wmarchewka/class_4_test/docs/portable_pinouts.xlsx

Sheet: rpi_pinouts
Header Pin Number | BCM Pin/Number | Portable Tester Usage |  |  | Header Pin Number | BCM Pin/Number | Portable Tester Usage | LCD
1 | 3V3 Power |  |  | SPI | 1 | 3V3 Power |  |  | SPI
2 | 5V Power |  |  | Ground | 17 | 3V3 Power |  |  | Ground
3 | BCM 2 (SDA) |  |  | Power | 2 | 5V Power |  |  | Power
4 | 5V Power |  |  | Rotary Encoder | 4 | 5V Power |  |  | Rotary Encoder
5 | BCM 3 (SCL) | Rotary Encoder 1 Pin B |  | Decoder | 27 | BCM 0 | I2C_SD EEPEOM | SHARED | Decoder
6 | Ground |  |  | LCD | 28 | BCM 1 | I2X_SC EEPROM | SHARED | LCD
7 | BCM 4 (GPCLK0) | Rotary Encoder 1 Pin A |  | I2C | 3 | BCM 2 (SDA) | LCD I2C SDA TOUCH |  | I2C
8 | BCM 14 (TXD) | Rotary Encoder 1 Pin B |  |  | 5 | BCM 3 (SCL) | LCD I2C SCL TOUCH
9 | Ground |  |  |  | 7 | BCM 4 (GPCLK0) | Rotary Encoder 1 Pin A
10 | BCM 15 (RXD) | Rotary Encoder 2 Pin A |  |  | 29 | BCM 5 | Decoder_0 PIN A
11 | BCM 17 | SPI1 CS1 | INT TS |  | 31 | BCM 6 | Decoder_0 PIN B
12 | BCM 18 (PWM0) | SPI1 CS0 |  |  | 26 | BCM 7 (CE1) | SPI_0 CS1
13 | BCM 27 | DISPLAY KEYIRQ |  |  | 24 | BCM 8 (CE0) | SPI_0 CS0
14 | Ground |  |  |  | 21 | BCM 9 (MISO) | MISO SPI_0
15 | BCM 22 | Rotary Encoder 2 Pin B |  |  | 19 | BCM 10 (MOSI) | MOSI SPI_0
16 | BCM 23 | Rotary Encoder 3 Pin A |  |  | 23 | BCM 11 (SCLK) | SCLK SPI_0
17 | 3V3 Power |  |  |  | 32 | BCM 12 (PWM0) | Rotary Encoder 4 Pin B
18 | BCM 24 | Rotary Encoder 3 Pin B |  |  | 33 | BCM13 (PWM 1) | Decoder_0 PIN C
19 | BCM 10 (MOSI) | MOSI SPI_0 |  |  | 8 | BCM 14 (TXD) | Rotary Encoder 1 Pin B
20 | Ground |  |  |  | 10 | BCM 15 (RXD) | Rotary Encoder 2 Pin A
21 | BCM 9 (MISO) | MISO SPI_0 |  |  | 36 | BCM 16 | SPI1 CS2
22 | BCM 25 | Rotary Encoder 4 Pin A |  |  | 11 | BCM 17 | SPI1 CS1
23 | BCM 11 (SCLK) | SCLK SPI_0 |  |  | 12 | BCM 18 (PWM0) | SPI1 CS0
24 | BCM 8 (CE0) | SPI0 CS0 |  |  | 35 | BCM 19 (MISO) | MISO SPI_1
25 | Ground |  |  |  | 38 | BCM 20 (MOSI) | MOSI SPI_1
26 | BCM 7 (CE1) | SPI0 CS1 |  |  | 40 | BCM 21 (SCLK) | SCLK SPI_1
27 | BCM 0 | I2C_SD EEPROM |  |  | 15 | BCM 22 | Rotary Encoder 2 Pin B
28 | BCM 1 | I2C_SC EEPROM |  |  | 16 | BCM 23 | Rotary Encoder 3 Pin A
29 | BCM 5 | Decoder_0 |  |  | 18 | BCM 24 | Rotary Encoder 3 Pin B
30 | Ground |  |  |  | 22 | BCM 25 | Rotary Encoder 4 Pin A
31 | BCM 6 | Decoder_0 |  |  | 37 | BCM 26 | FREE PIN
32 | BCM 12 (PWM0) | Rotary Encoder 4 Pin B |  |  | 13 | BCM 27 | DISPLAY KEYIRQ |  | NOT NEEDED
33 | BCM13 (PWM 1) | Decoder_0 |  |  | 6 | Ground
34 | Ground |  |  |  | 9 | Ground
35 | BCM 19 (MISO) | MISO SPI_1 |  |  | 14 | Ground
36 | BCM 16 | SPI1 CS2 |  |  | 20 | Ground
37 | BCM 26 | FREE PIN |  |  | 25 | Ground
38 | BCM 20 (MOSI) | MOSI SPI_1 |  |  | 30 | Ground
39 | Ground |  |  |  | 34 | Ground
40 | BCM 21 (SCLK) | SCLK SPI_1 |  |  | 39 | Ground

Sheet: IC PINOUTS
MAIN FUNCTION | IC | IC NAME | FUNCTION | PIN | IC FUNCTION | NET | FROM | TO | DESCRIPTION
TRACK RCV CODE RATE GEN | U1 | AD9833WBRMZ | SIGNAL GENERATOR PRIMARY | 6 | SDATA | BCM20_MOSI1 | PCBA |  | SPI1 DATA
TRACK RCV CODE RATE GEN | U1 | AD9833WBRMZ | SIGNAL GENERATOR PRIMARY | 7 | SCLK | BCM21_SCK1 | PCBA |  | SPI1 CLOCK
TRACK RCV CODE RATE GEN | U1 | AD9833WBRMZ | SIGNAL GENERATOR PRIMARY | 5 | MCLK | CLK1 | U11 |  | CLOCK SIGNAL
TRACK RCV CODE RATE GEN | U1 | AD9833WBRMZ | SIGNAL GENERATOR PRIMARY | 8 | FSYNC | CS0 | U21.15 |  | CHIP SELECT
TRACK RCV CODE RATE GEN | U1 | AD9833WBRMZ | SIGNAL GENERATOR PRIMARY | 10 | VOUT | PRIMARY CHANNEL | U1.10 |  | PRIMARY CHANNEL OUTPUT
TRACK RCV CODE RATE GEN | U10 | OPA552UA | SIGNAL AMPLIFIER | 2 | INPUT POS
TRACK RCV CODE RATE GEN | U10 | OPA552UA | SIGNAL AMPLIFIER | 3 | INPUT NEG |  | U9.8
TRACK RCV CODE RATE GEN | U10 | OPA552UA | SIGNAL AMPLIFIER | 6 | OUTPUT |  |  | TPA2
TRACK RCV CODE RATE GEN | U11 | 551MILF | CLOCK BUFFER | 2 | Q1 | CLK1 |  | U1.5 | CLOCK USED FOR SIGNAL GENERATOR
TRACK RCV CODE RATE GEN | U11 | 551MILF | CLOCK BUFFER | 3 | Q2 | CLK2 |  | U5.5 | CLOCK USED FOR SIGNAL GENERATOR
TRACK RCV CODE RATE GEN | U11 | 551MILF | CLOCK BUFFER | 1 | ICLK |  | Y1.3
SPEED SIMULATION TACH 1 | U12 | ADUM3154ARSZ | SPI ISOLATOR | 4 | MO | BCM20_MOSI1 | PCBA.20
SPEED SIMULATION TACH 1 | U12 | ADUM3154ARSZ | SPI ISOLATOR | 3 | MCLK | BCM21_SCK1 | PCBA.21
SPEED SIMULATION TACH 1 | U12 | ADUM3154ARSZ | SPI ISOLATOR | 18 | SCLK | CS_TACH1 |  | U14.8
SPEED SIMULATION TACH 1 | U12 | ADUM3154ARSZ | SPI ISOLATOR | 6 | MSS | CS6 | U21.9
SPEED SIMULATION TACH 1 | U12 | ADUM3154ARSZ | SPI ISOLATOR | 17 | SI | MOSI2_TACH1 |  | U14.6
SPEED SIMULATION TACH 1 | U12 | ADUM3154ARSZ | SPI ISOLATOR | 15 | SS0 | SCK2_TACH1 |  | U14.7
SPEED SIMULATION TACH 2 | U13 | ADUM3154ARSZ | SPI ISOLATOR | 4 | MO | BCM20_MOSI1 | PCBA.20
SPEED SIMULATION TACH 2 | U13 | ADUM3154ARSZ | SPI ISOLATOR | 3 | MCLK | BCM21_SCK1 | PCBA.21
SPEED SIMULATION TACH 2 | U13 | ADUM3154ARSZ | SPI ISOLATOR | 18 | SCLK | CS_TACH2 |  | U17.8
SPEED SIMULATION TACH 2 | U13 | ADUM3154ARSZ | SPI ISOLATOR | 6 | MSS | CS7 | U21.7
SPEED SIMULATION TACH 2 | U13 | ADUM3154ARSZ | SPI ISOLATOR | 17 | SI | MOSI2_TACH2 |  | U17.6
SPEED SIMULATION TACH 2 | U13 | ADUM3154ARSZ | SPI ISOLATOR | 15 | SS0 | SCK2_TACH2 |  | U17.7
SPEED SIMULATION TACH 1 | U14 | AD9833WBRMZ | SIGNAL GENERATOR PRIMARY | 5 | MCLK | CLK_TACH1 | Y2.3 | U15.2
SPEED SIMULATION TACH 1 | U14 | AD9833WBRMZ | SIGNAL GENERATOR PRIMARY | 6 | SDATA | MOSI2_TACH1 | U12.17
SPEED SIMULATION TACH 1 | U14 | AD9833WBRMZ | SIGNAL GENERATOR PRIMARY | 7 | SCLK | SCK2_TACH1 | U12.18
SPEED SIMULATION TACH 1 | U14 | AD9833WBRMZ | SIGNAL GENERATOR PRIMARY | 8 | FSYNC | CS_TACH1 | U12.15
SPEED SIMULATION TACH 1 | U14 | AD9833WBRMZ | SIGNAL GENERATOR PRIMARY | 10 | VOUT |  |  | TP16,U15.2
SPEED SIMULATION TACH 1 | U15 | MC33071ADR2G | GAIN CONTROL PRIMARY | 2 | INPUT NEG |  | U14.10
SPEED SIMULATION TACH 1 | U15 | MC33071ADR2G | GAIN CONTROL PRIMARY | 3 | INPUT POS
SPEED SIMULATION TACH 1 | U15 | MC33071ADR2G | GAIN CONTROL PRIMARY | 6 | OUTPUT |  |  | U16.2
SPEED SIMULATION TACH 1 | U16 | MC33071ADR2G | GAIN CONTROL PRIMARY | 2 | INPUT NEG |  | U15.6
SPEED SIMULATION TACH 1 | U16 | MC33071ADR2G | GAIN CONTROL PRIMARY | 3 | INPUT POS
SPEED SIMULATION TACH 1 | U16 | MC33071ADR2G | GAIN CONTROL PRIMARY | 6 | OUTPUT |  |  | TP20
SPEED SIMULATION TACH 2 | U17 | AD9833WBRMZ | SIGNAL GENERATOR PRIMARY | 5 | MCLK | CLK_TACH2 | Y3.3
SPEED SIMULATION TACH 2 | U17 | AD9833WBRMZ | SIGNAL GENERATOR PRIMARY | 6 | SDATA | MOSI2_TACH2 | U13.17
SPEED SIMULATION TACH 2 | U17 | AD9833WBRMZ | SIGNAL GENERATOR PRIMARY | 7 | SCLK | SCK2_TACH2 | U13.18
SPEED SIMULATION TACH 2 | U17 | AD9833WBRMZ | SIGNAL GENERATOR PRIMARY | 8 | FSYNC | CS_TACH2 | U13.15
SPEED SIMULATION TACH 2 | U17 | AD9833WBRMZ | SIGNAL GENERATOR PRIMARY | 10 | VOUT |  |  | TP18,U18.2
SPEED SIMULATION TACH 2 | U18 | MC33071ADR2G | GAIN CONTROL PRIMARY | 2 | INPUT NEG |  | U17.10
SPEED SIMULATION TACH 2 | U18 | MC33071ADR2G | GAIN CONTROL PRIMARY | 3 | INPUT POS
SPEED SIMULATION TACH 2 | U18 | MC33071ADR2G | GAIN CONTROL PRIMARY | 6 | OUTPUT |  |  | U19.2
SPEED SIMULATION TACH 2 | U19 | MC33071ADR2G | GAIN CONTROL PRIMARY | 2 | INPUT NEG |  | U18.6
SPEED SIMULATION TACH 2 | U19 | MC33071ADR2G | GAIN CONTROL PRIMARY | 3 | INPUT POS
SPEED SIMULATION TACH 2 | U19 | MC33071ADR2G | GAIN CONTROL PRIMARY | 6 | OUTPUT |  |  | TP21,JS2
TRACK RCV CODE RATE GEN | U2 | MAX5484EUD | GAIN CONTROL PRIMARY | 5 | DIN | BCM20_MOSI1 | PCBA.22 |  | SPI1 DATA
TRACK RCV CODE RATE GEN | U2 | MAX5484EUD | GAIN CONTROL PRIMARY | 4 | SCLK | BCM21_SCK1 | PCBA.21 |  | SPI1 CLOCK
TRACK RCV CODE RATE GEN | U2 | MAX5484EUD | GAIN CONTROL PRIMARY | 3 | CS | CS1 | U21.14 |  | CHIP SELECT
TRACK RCV CODE RATE GEN | U2 | MAX5484EUD | GAIN CONTROL PRIMARY | 10 | W |  |  | U4.2 | WIPER
TRACK RCV CODE RATE GEN | U2 | MAX5484EUD | GAIN CONTROL PRIMARY | 11 | L |  |  | U3.11 | SIGNAL CASCADED TO U3
SPEED SIMULATION TACH 1 | U20 | MCP23S08-E/SO | ENCODER SPEED 1 | 3 | SO | BCM19_MISO1 | PCBA.21
SPEED SIMULATION TACH 1 | U20 | MCP23S08-E/SO | ENCODER SPEED 1 | 2 | SI | BCM20_MOSI1 | PCBA.20
SPEED SIMULATION TACH 1 | U20 | MCP23S08-E/SO | ENCODER SPEED 1 | 1 | SCK | BCM21_SCK1 | PCB1.21
SPEED SIMULATION TACH 1 | U20 | MCP23S08-E/SO | ENCODER SPEED 1 | 7 | CS | CS9 | U22.14
SPEED SIMULATION TACH 1 | U20 | MCP23S08-E/SO | ENCODER SPEED 1 | 10 | GP0 | GP0 |  | SW3-A
SPEED SIMULATION TACH 1 | U20 | MCP23S08-E/SO | ENCODER SPEED 1 | 11 | GP1 | GP1 |  | SW4-A
SPEED SIMULATION TACH 1 | U20 | MCP23S08-E/SO | ENCODER SPEED 1 | 12 | GP2 | GP2 |  | SW5-A
SPEED SIMULATION TACH 1 | U20 | MCP23S08-E/SO | ENCODER SPEED 1 | 13 | GP3 | GP3 |  | SW6-A
MAIN | U21 | SN7HC138DR | CHIP SELECT GENERATOR | 3 | C | BCM13 | PCBA.13
MAIN | U21 | SN7HC138DR | CHIP SELECT GENERATOR | 4 | G2A | BCM16 | PCBA.16
MAIN | U21 | SN7HC138DR | CHIP SELECT GENERATOR | 1 | AO | BCM5 | PCBA.5
MAIN | U21 | SN7HC138DR | CHIP SELECT GENERATOR | 2 | B | BCM6 | PCBA.6
MAIN | U21 | SN7HC138DR | CHIP SELECT GENERATOR | 15 | Y0 | CS0 |  | U1.8
MAIN | U21 | SN7HC138DR | CHIP SELECT GENERATOR | 14 | Y1 | CS1 |  | U2.3
MAIN | U21 | SN7HC138DR | CHIP SELECT GENERATOR | 13 | Y2 | CS2 |  | U5.8
MAIN | U21 | SN7HC138DR | CHIP SELECT GENERATOR | 12 | Y3 | CS3 |  | U6.3
MAIN | U21 | SN7HC138DR | CHIP SELECT GENERATOR | 11 | Y4 | CS4 |  | U7.3
MAIN | U21 | SN7HC138DR | CHIP SELECT GENERATOR | 10 | Y5 | CS5 |  | U3.3
MAIN | U21 | SN7HC138DR | CHIP SELECT GENERATOR | 9 | Y6 | CS6 |  | U12.6
MAIN | U21 | SN7HC138DR | CHIP SELECT GENERATOR | 7 | Y7 | CS7 |  | U13.6
MAIN | U22 | SN7HC138DR | CHIP SELECT GENERATOR | 3 | C | BCM13 | PCBA.13
MAIN | U22 | SN7HC138DR | CHIP SELECT GENERATOR | 4 | G2A | BCM16 | PCBA.16
MAIN | U22 | SN7HC138DR | CHIP SELECT GENERATOR | 1 | AO | BCM5 | PCBA.5
MAIN | U22 | SN7HC138DR | CHIP SELECT GENERATOR | 2 | B | BCM6 | PCBA.6
MAIN | U22 | SN7HC138DR | CHIP SELECT GENERATOR | 15 | Y0 | CS8 |  | U25.6
MAIN | U22 | SN7HC138DR | CHIP SELECT GENERATOR | 14 | Y1 | CS9 |  | U20.7
LOOP CURRENT SENSE | U23 | ACST711ELCTR-25AB-T | HALL EFFECT CURRENT SENSOR | 1 | IP+ |  | JP2-1, JP-2, JP-3
LOOP CURRENT SENSE | U23 | ACST711ELCTR-25AB-T | HALL EFFECT CURRENT SENSOR | 2 | IP+ |  | JP2-1, JP-2, JP-3
LOOP CURRENT SENSE | U23 | ACST711ELCTR-25AB-T | HALL EFFECT CURRENT SENSOR | 3 | IP- |  | JP-4, JP-5, JP-6
LOOP CURRENT SENSE | U23 | ACST711ELCTR-25AB-T | HALL EFFECT CURRENT SENSOR | 4 | IP- |  | JP-4, JP-5, JP-6
LOOP CURRENT SENSE | U23 | ACST711ELCTR-25AB-T | HALL EFFECT CURRENT SENSOR | 7 | VIOUT |  |  | U24.3
LOOP CURRENT SENSE | U24 | MC33071ADR2G | AMP | 2 | POS |  | U23.7
LOOP CURRENT SENSE | U24 | MC33071ADR2G | AMP | 3 | NEG
LOOP CURRENT SENSE | U24 | MC33071ADR2G | AMP | 6 | OUTPUT |  |  | U25.3
LOOP CURRENT SENSE | U25 | AD7940BRJZ | A/D CONVERTER | 3 | VIN |  | U24.6
LOOP CURRENT SENSE | U25 | AD7940BRJZ | A/D CONVERTER | 4 | SCLK | BCM21_SCK1 | PCBA.21
LOOP CURRENT SENSE | U25 | AD7940BRJZ | A/D CONVERTER | 5 | SDATA | BCM19_MISO1 | PCBA.19
LOOP CURRENT SENSE | U25 | AD7940BRJZ | A/D CONVERTER | 6 | CS | CS8 | U22.15
LOOP CURRENT SENSE | U26 | LM4128CQ1MF3.3/NOPB | VOLTAGE REFERENCE FOR U25 | 4 | VIN |  |  | U25.1
LOOP CURRENT SENSE | U26 | LM4128CQ1MF3.3/NOPB | VOLTAGE REFERENCE FOR U25 | 5 | VREF
MAIN | U27 | CAT24C32WI-GT3 | EEPROM | 6 | SCLK | BCM0_ID_SD | PCB1.0 |  | EEPROM SPI CLOCK
MAIN | U27 | CAT24C32WI-GT3 | EEPROM | 5 | SDA | BCM1_ID_SC | PCBA.1 |  | EEPROM SPI DATA
TRACK RCV CODE RATE GEN | U3 | MAX5484EUD | GAIN CONTROL PRIMARY | 5 | DIN | BCM20_MOSI1 | PCBA.22 |  | SPI1 DATA
TRACK RCV CODE RATE GEN | U3 | MAX5484EUD | GAIN CONTROL PRIMARY | 4 | SCLK | BCM21_SCK1 | PCBA.21 |  | SPI1 CLOCK
TRACK RCV CODE RATE GEN | U3 | MAX5484EUD | GAIN CONTROL PRIMARY | 3 | CS | CS5 | U21.10 |  | CHIP SELECT
TRACK RCV CODE RATE GEN | U3 | MAX5484EUD | GAIN CONTROL PRIMARY | 10 | W |  |  | U4.6 | WIPER
TRACK RCV CODE RATE GEN | U3 | MAX5484EUD | GAIN CONTROL PRIMARY | 11 | L |  | U2.10 |  | GAIN OUT
TRACK RCV CODE RATE GEN | U4 | MC33071ADR2G | GAIN CONTROL PRIMARY | 3 | INPUT NEG |  | U2.11
TRACK RCV CODE RATE GEN | U4 | MC33071ADR2G | GAIN CONTROL PRIMARY | 4 | INPUT POS
TRACK RCV CODE RATE GEN | U4 | MC33071ADR2G | GAIN CONTROL PRIMARY | 6 | OUTPUT |  |  | TP1
TRACK RCV CODE RATE GEN | U5 | AD9833WBRMZ | SIGNAL GENERATOR SECONDARY | 6 | SDATA | BCM20_MOSI1 | PCBA |  | SPI1 DATA
TRACK RCV CODE RATE GEN | U5 | AD9833WBRMZ | SIGNAL GENERATOR SECONDARY | 7 | SCLK | BCM21_SCK1 | PCBA |  | SPI1 CLOCK
TRACK RCV CODE RATE GEN | U5 | AD9833WBRMZ | SIGNAL GENERATOR SECONDARY | 5 | MCLK | CLK2 | U11 |  | CLOCK SIGNAL
TRACK RCV CODE RATE GEN | U5 | AD9833WBRMZ | SIGNAL GENERATOR SECONDARY | 8 | FSYNC | CS2 | U21.13 |  | CHIP SELECT
TRACK RCV CODE RATE GEN | U5 | AD9833WBRMZ | SIGNAL GENERATOR SECONDARY | 10 | VOUT | PRIMARY CHANNEL | U1.10 |  | PRIMARY CHANNEL OUTPUT
TRACK RCV CODE RATE GEN | U6 | MAX5484EUD | GAIN CONTROL SECONDARY | 5 | DIN | BCM20_MOSI1 | PCBA.22 |  | SPI1 DATA
TRACK RCV CODE RATE GEN | U6 | MAX5484EUD | GAIN CONTROL SECONDARY | 4 | SCLK | BCM21_SCK1 | PCBA.21 |  | SPI1 CLOCK
TRACK RCV CODE RATE GEN | U6 | MAX5484EUD | GAIN CONTROL SECONDARY | 3 | CS | CS3 | U21.12 |  | CHIP SELECT
TRACK RCV CODE RATE GEN | U6 | MAX5484EUD | GAIN CONTROL SECONDARY | 10 | W |  |  | U8.2 | WIPER
TRACK RCV CODE RATE GEN | U6 | MAX5484EUD | GAIN CONTROL SECONDARY | 11 | L |  |  | U7.11 | SIGNAL CASCADED TO U3
TRACK RCV CODE RATE GEN | U7 | MAX5484EUD | GAIN CONTROL SECONDARY | 5 | DIN | BCM20_MOSI1 | PCBA.22 |  | SPI1 DATA
TRACK RCV CODE RATE GEN | U7 | MAX5484EUD | GAIN CONTROL SECONDARY | 4 | SCLK | BCM21_SCK1 | PCBA.21 |  | SPI1 CLOCK
TRACK RCV CODE RATE GEN | U7 | MAX5484EUD | GAIN CONTROL SECONDARY | 3 | CS | CS4 | U21.11 |  | CHIP SELECT
TRACK RCV CODE RATE GEN | U7 | MAX5484EUD | GAIN CONTROL SECONDARY | 10 | W |  |  | U8.6 | WIPER
TRACK RCV CODE RATE GEN | U7 | MAX5484EUD | GAIN CONTROL SECONDARY | 11 | L |  | U6.10 |  | GAIN OUT
TRACK RCV CODE RATE GEN | U8 | MC33071ADR2G | GAIN CONTROL SECONDARY | 3 | INPUT NEG |  | U6.11
TRACK RCV CODE RATE GEN | U8 | MC33071ADR2G | GAIN CONTROL SECONDARY | 4 | INPUT POS
TRACK RCV CODE RATE GEN | U8 | MC33071ADR2G | GAIN CONTROL SECONDARY | 6 | OUTPUT |  |  | U8.2 | TP2
TRACK RCV CODE RATE GEN | U9 | ADG704BRMZ | SIGNAL SELECT | 1 | AO | BCM26 | PCBA.26
TRACK RCV CODE RATE GEN | U9 | ADG704BRMZ | SIGNAL SELECT | 2 | S1 |  | U4.6
TRACK RCV CODE RATE GEN | U9 | ADG704BRMZ | SIGNAL SELECT | 8 | S2 |  | U8.6
TRACK RCV CODE RATE GEN | U9 | ADG704BRMZ | SIGNAL SELECT | 9 | D |  |  | U10.2
