wmarchewka/class_4_test/docs/AD8246.docx

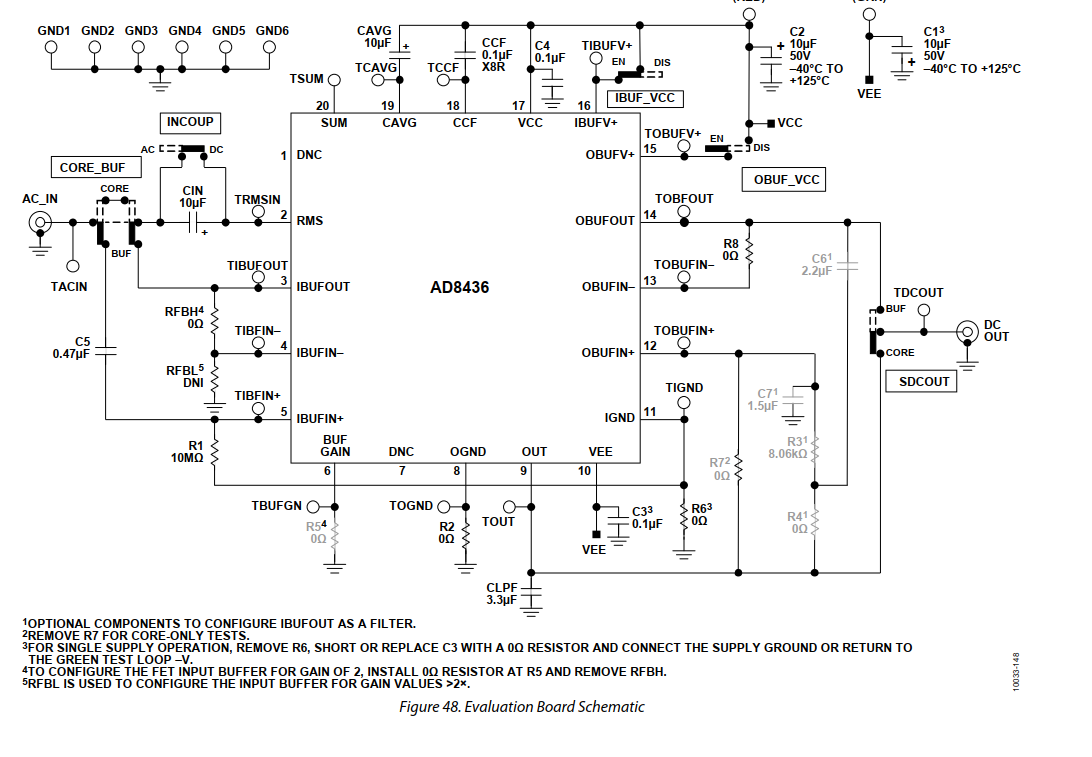
[picture p1: figure]
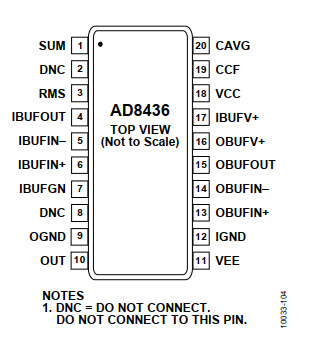
[picture p2: figure]
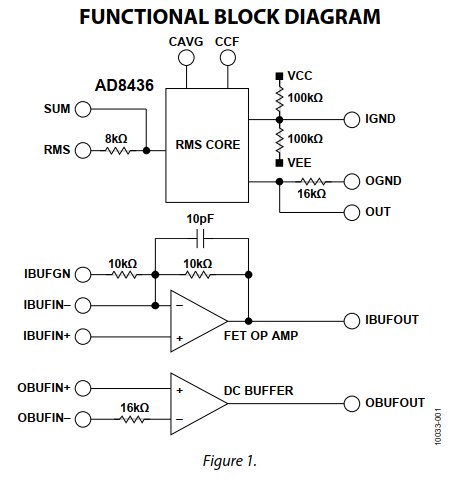
[picture p3: figure]
