wmarchewka/class_4_test/docs/AD8246_walt1.pdf

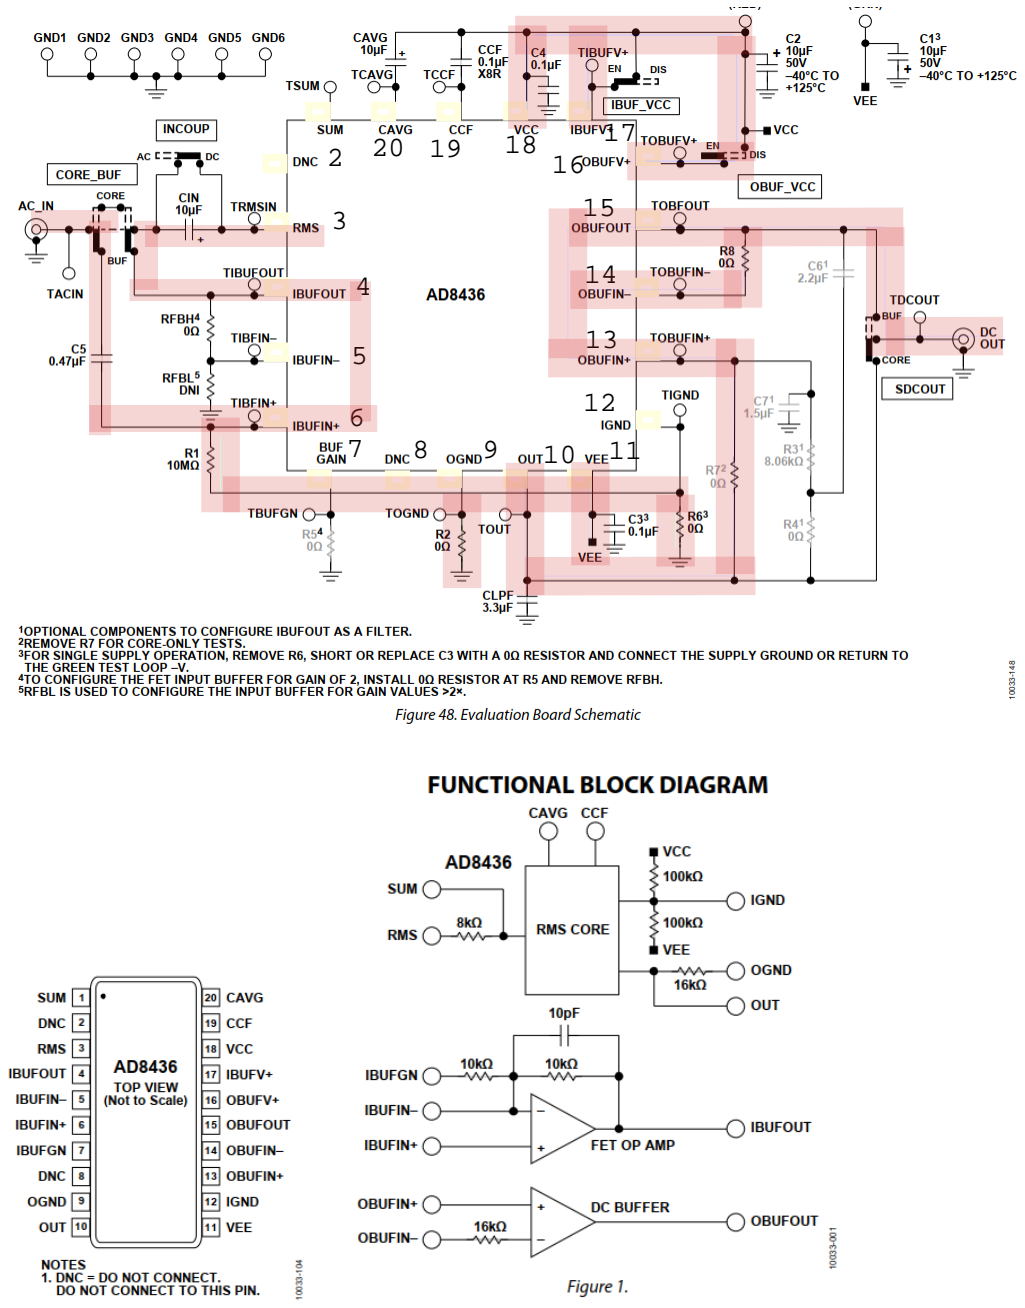
[picture p4: figure]
