wmarchewka/class_4_test/docs/D3005H100-A/D3005H100_A_A01_BOM.xlsx

QTY | SIEMENS P/N | MFG. NAME | MANUFACTURER P/N | REFERENCE DESIGNATORS | DESCRIPTION | VALUE
3 |  |  |  | FID1-3 | FIDUCIAL MARK
4 |  |  |  | X5-8 | STANDOFF 217
4 |  |  |  | X1-4 | STANDOFF,150 HOLE,250 DIA STANDOFF
3 | 112008 | MULTICOMP | MCGPR63V476M8X11-RH | C40 C46 C52 | CAP,POL,47UF,AL-EL,63V,20%,8X11 | 47uF
1 | 128327 | LITE-ON | LTL2R3KRD-EM | LD1 | LED,DOME,UBRT,1.8V,10MA,RED,642NM,TH,50MCD@2MA | RED
3 | 165048 | XP POWER | IMM0212D03 | PWR1-3 | IC,D/C CONV,21.8MMX9.2MM,9-18V,+/-3.3,303MA | IMM0212D03
4 | 200050 | BOURNS | PEC11R-4230F-S0012 | SW3-6 | SWITCH,RTRY-ENCODER,MECH,12PPR,MOM,SPST | PEC11R-4230F-S0012
2 | 202036 | CARLING TECHNOLOGIES | 7101SY9V3BE | SW1-2 | SPDT SWITCH ON/ON PC MOUNT | SPDT
1 | 304098 | SAMTEC | SSW-120-02-G-D-LL | JS3 | HDR,VERT,40P,2.54MM,2X20,TH,SQ | 40P
8 | 328002 | KEYSTONE | 1039 | TPA1-8 | TEST POINT,TERM,SLOTTED,PC MNT,TH,TIN | 1039
21 | 329004 | OXLEY | 050/SO/BK2F | TP7-16 TP18 TP23-32 | TEST POINT,TERM,TH | DNP
11 | 329004 | OXLEY | 050/SO/BK2F | TP1-6 TP17 TP19-22 | TEST POINT,TERM,TH | KINKY
1 | 344083 | AMP | 207444-8 | JP1 | HDR,VERT,18P,5MM,3X6,TH,FRICTLK | 18P
1 | 344115 | AMP | 207158-3 | JP2 | HDR,VERT,6P,5MM,2X3,TH,FRICTLK | 6P
1 | 344173 | MOLEX | 22-11-2022 | JP3 | HDR,VERT,2P,2.54MM,TH,SQ | 2P
1 | 344175 | TE CONNECTIVITY | 1586037-4 | JP4 | CONN,VERT,4P,4.2MM,2X2,RCPT,TH | 4P
2 | 344201 | TYCO / AMP | 5227222-3 | JS1-2 | CONN,STR,1P,SMB,JACK,TH,SCRLK | BNC
1 | 486068 | BRADY | THT-48-423-10 | LAB1 | LABEL,THT,POLYEST,2"X0.25",WHT,GLOSSY
13 | 9100000001 | VISHAY DALE | CRCW12060000ZSTA | R3 R5 R9 R12 R14 R18 R36 R38 R45 R47 R85-87 | RES,0R,JMPR,1/4W,3.5A,1206 | 0R
1 | 9113171000 | VISHAY DALE | CRCW1206100RFKEA | R63 | RES,100R,THKF,1/4W,1%,1206,100PPM | 100R
25 | 9113171001 | VISHAY DALE | CRCW12061K00FKEA | R2 R4 R11 R13 R19-21 R26 R29 R31-33 R35 R42 R44 R52-53 R62 R88-92 R95-96 | RES,1K,THKF,1/4W,1%,1206,100PPM | 1K
35 | 9113171002 | VISHAY DALE | CRCW120610K0FKEA | R8 R17 R22 R24 R40 R49 R51 R54-60 R64-84 | RES,10K,THKF,1/4W,1%,1206,100PPM | 10K
1 | 9113171002 | VISHAY DALE | CRCW120610K0FKEA | R23 | RES,10K,THKF,1/4W,1%,1206,100PPM | DNP
1 | 9113171501 | PANASONIC | ERJ-8ENF1501V | R1 | RES,1.5K,THKF,1/4W,1%,1206,100PPM | 1.5K
4 | 9113172001 | VISHAY DALE | CRCW12062K00FKEA | R6-7 R15-16 | RES,2K,THKF,1/4W,1%,1206,100PPM | 2K
2 | 9113173320 | VISHAY DALE | CRCW1206332RFKEA | R39 R48 | RES,332R,THKF,1/4W,1%,1206,100PPM | 332R
2 | 9113173921 | VISHAY DALE | CRCW12063K92FKEA | R93-94 | RES,3.92K,THKF,1/4W,1%,1206,100PPM | 3.92K
6 | 9113175111 | VISHAY DALE | CRCW12065K11FKEA | R10 R34 R37 R43 R46 R61 | RES,5.11K,THKF,1/4W,1%,1206,100PPM | 5.11K
1 | 91131751R0 | VISHAY DALE | CRCW120651R0FKEA | R25 | RES,51R,THKF,1/4W,1%,1206,100PPM | 51R
5 | 91131833R0 | PANASONIC | ERJ-8GEYJ330V | R27-28 R30 R41 R50 | RES,33R,THKF,1/4W,5%,1206,200PPM | 33R
5 | 9212147103 | AVX | 08053C103KAT2A | C5 C18 C34 C61 C74 | CAP,10NF,CER,25V,10%,X7R,0805 | 10nF
2 | 9213143476 | SAMSUNG | CL31A476KQHNNNE | C7 C20 | CAP,47UF,CER,6.3V,10%,X5R,1206 | 47uF
1 | 9213147105 | AVX | 12063C105KAT2A | C90 | CAP,1UF,CER,25V,10%,X7R,1206 | 1uF
5 | 9213149101 | KEMET | C1206C101K5GACTU | C6 C19 C31 C62 C75 | CAP,100PF,CER,50V,10%,C0G,1206 | 100pF
48 | 9213149104 | KEMET | C1206C104K5RACTU | C2-3 C8-11 C13 C15-16 C21-24 C26-27 C29-30 C33 C35-38 C58-59 C65-67 C69 C71-72 C78-80 C82-88 C91 C93 C95 C118-119 C122-123 C126 | CAP,100NF,CER,50V,10%,X7R,1206 | 100nF
3 | 9213149475 | TAIYO YUDEN | UMK316ABJ475KD-T | C43 C49 C55 | CAP,4.7UF,CER,50V,10%,X5R,1206 | 4.7uF
8 | 921314B103 | KEMET | C1206C103K1RACAUTO | C97-98 C100-101 C103-104 C106-107 | CAP,10NF,CER,100V,10%,X7R,1206 | 10nF
16 | 921314B104 | KEMET | C1206C104K1RACAUTO | C39 C42 C45 C48 C51 C54 C89 C99 C102 C105 C108 C113-116 C128 | CAP,100NF,CER,100V,10%,X7R,1206 | 100nF
3 | 9213164476 | MURATA | GRM31CR61A476ME15L | C41 C47 C53 | CAP,47UF,CER,10V,20%,X5R,1206 | 47uF
4 | 9213168106 | TAIYO YUDEN | GMK316F106ZL-T | C81 C92 C96 C111 | CAP,10UF,CER,35V,20%,1206 | 10uF
1 | 9213168106 | TAIYO YUDEN | GMK316F106ZL-T | C94 | CAP,10UF,CER,35V,20%,1206 | DNP
8 | 9218247476 | VISHAY | TR3D476K025C0150 | C28 C32 C63 C68 C76 C109-110 C112 | CAP,POL,47UF,TANT,25V,10%,2917,0.15R | 47uF
19 | 9219264106 | KEMET | T491B106M010AT | C1 C4 C12 C14 C17 C25 C44 C50 C56-57 C60 C70 C73 C117 C120-121 C124-125 C127 | CAP,POL,10UF,TANT,10V,20%,1411,3.5R | 10uF
1 | 9321100007 | TEXAS INST | LM4128CQ1MF3.3/NOPB | U26 | DIODE,ZEN,LM4128,3.3V@20MA,0.5%,SOT-23 | LM4128CQ1MF3.3/NOPB
3 | 9352000002 | LITTLEFUSE | SMCJ18CA | VR1-3 | DIODE,XIENT,BIDIR,18V,29.2V,1UA,D0241AB | 18V
2 | 9352190006 | LITTLEFUSE | SMAJ20CA | VR4-5 | DIODE,XIENT,BIDIR,20V,32.4V,1UA,DO214AC | 20V
1 | 9411100002 | ANALOG DEVICES | ADG704BRMZ-REEL | U9 | IC,MULTIPLEXER,4X1,10-MSOP | ADG704BRMZ
7 | 9411108002 | ON SEMI | MC33071ADR2G | U4 U8 U15-16 U18-19 U24 | IC,OP-AMP,GP,4.5MHZ,8SOIC | MC33071ADR2G
1 | 9411108003 | TEXAS INSTRUMENT | OPA552UA | U10 | IC,OP-AMP,GP,12MHZ,8SOIC | OPA552UA
2 | 9421100011 | TEXAS INSTRUMENT | SN74HC138DR | U21-22 | IC,DCDR,3-8 LINE,SOIC-16 | SN74HC138DR
1 | 9431000004 | IDT | 551MILF | U11 | IC,CLK BUFFER 1:4,160MHZ,8SOIC | 551MILF
1 | 9432100006 | ON SEMICONDUCTOR | CAT24C32WI-GT3 | U27 | IC,MEM,EEPROM,32Kb,(4KX8),400NS,SOIC8 | CAT24C32WI-GT3
1 | 9433100001 | ANALOG DEVICES | AD7940BRJZ | U25 | IC,ADC,14BITS,100KSPS,SOT23 | AD7940BRJZ
2 | 9436000002 | MAXIM INTEGRATED | MAX5484EUD+ | U2 U6 | IC,DGTL POT,10BIT,NV,14TSSOP | MAX5484EUD+
4 | 9436000003 | ANALOG DEVICES | AD9833WBRMZ | U1 U5 U14 U17 | IC,WAVEFORM GENERTR PROG,10-MSOP | AD9833WBRMZ
2 | 9436000004 | MAXIM INTEGRATED | MAX5481EUD+ | U3 U7 | IC,DGTL POT,10K,10BIT,NV,14TSSOP | MAX5481EUD+
2 | 9451000004 | ANALOG DEVICES | ADUM3154ARSZ | U12-13 | IC,DGTL,ISOLN,4-CHN,SPI,3.75KV,20SSOP | ADUM3154ARSZ
3 | 9461000003 | MICROCHIP TECH | DSC1001CI5-004.9152T | Y1-3 | OSC,XTLO,4.9152MHZ,CMOS,SMT | 4.9152 MHz
1 | 9462000002 | ALLEGRO | ACST711ELCTR-25AB-T | U23 | IC,SENSOR CURRENT HALL,AC/DC,25A,SOIC-8 | ACST711ELCTR-25AB-T
1 | 9465000001 | MICROCHIP | MCP23S08-E/SO | U20 | IC,I/O EXPANDER SPI,8B,SOIC-18 | MCP23S08-E/SO
1 | 9631113030 | HIROSE ELCTRIC CO LTD. | FH12A-30S--0.5SH(55) | JS4 | CONN,RTANG,30P,0.5MM,1X30,FFC/FPC,SMT,TC | 30P
