wmarchewka/class_4_test/docs/Compute Module/Board Design/RPI-CMIO-V3_0-PUBLIC-BOM.xlsx

Raspberry Pi Compute Module IO Board Revised: Thursday, Sept 21, 2015
RPI-CMIO Revision: 3.0
Item | Quantity | Reference | Part | Voltage | Current | Power | Material | Size | Tolerance | Manufacturer | Manuf. Part No | Description
1 | 4 | C7,C8,C11,C12 | 10u | 6.3V |  |  | X7R | 2012 | 20% | Generic | Generic | CAP, CHIP, 2012, 10u, 20%, 6.3V
2 | 6 | C2,C19,C20,C1,C3,C10 | 47u | 6.3V |  |  | X7R | 3216 | 20% | Generic | Generic | CAP, CHIP, 3216, 47u, 20%, 6.3V
3 | 3 | C4,C13,C14 | 1u | 6.3V |  |  | X7R | 1005 | 10% | Generic | Generic | CAP, CHIP, 1005, 1u, 10%, 6.3V
4 | 3 | C5, C23, C24 | 4.7u | 6.3V |  |  | X7R | 1608 | 20% | Generic | Generic | CAP, CHIP, 1608, 4.7u, 20%, 6.3V
5 | 5 | C6,C9,C15,C16,C17 | 100n | 6.3V |  |  | X7R | 1005 | 10% | Generic | Generic | CAP, CHIP, 1005, 100n, 10%, 6.3V
6 | 2 | C21,C22 | NO FIT |  |  |  |  | 1005 |  | Generic | Generic | CAP, CHIP, 1005
7 | 1 | D1 | RED |  |  |  |  | 1608 |  | Generic | Generic | LED, SMT, 1608, RED
8 | 1 | D2 | GREEN |  |  |  |  | 1608 |  | Generic | Generic | LED, SMT, 1608, GREEN
9 | 1 | F1 | MF-MSMF200 | 6V | 2.0A |  |  |  |  | Bourns | MF-MSMF200 | Polyfuse, 2.0A hold, 4.0A trip
10 | 1 | J1 | DDR2 SODIMM |  |  |  |  |  |  | Amphenol | T632S252200-4TAB | DDR2 SODIMM Socket
11 | 2 | J2,J15 | 10103594-0001LF |  |  |  |  |  |  | FCI | 10103594-0001LF | Socket, uUSB, B, RA, PTH/SMT
12 | 1 | J4 | 3W 0.1" PIN HDR |  |  |  |  |  |  | Generic | Generic | 3W 0.1" pin header single row
13 | 2 | J5,J6 | 60W 0.1" PIN HDR |  |  |  |  |  |  | Generic | Generic | 60W 0.1" pin header (2 rows x30)
14 | 1 | J7 | 1734592-8 |  |  |  |  |  |  | TE | 1734592-8 | 0.5MM FFC 8W RA BOTTOM CONTACT SMT
15 | 1 | J16 | 1040310811 |  |  |  |  |  |  | Molex | 1040310811 | uSD, Normal Mount, SMT, Push-Pull
16 | 4 | J9,J10,J11,J12 | 54548-2271 |  |  |  |  |  |  | Molex | 54548-2271 | 0.5MM FFC 22W RA BC
17 | 1 | J13 | 47151-1051 |  |  |  |  |  |  | Molex | 47151-1051 | HDMI Con, RA, SMT with PTH lugs
18 | 1 | J14 | Toby Electronics |  |  |  |  |  |  | Toby Electronics | 317AE04PSA1A03-R | USB A Standard Single PTH RA
19 | 2 | L1,L2 | 4.7u |  | 2A |  |  | 4x4mm | 20% | Bourns | SRN4018-4R7M | Semi shielded power inductor, 4.7uH, Isat=2A, Irma=1.9A, R=84mR
20 | 5 | Q1,Q2,Q3,Q4,Q5 | DMG1012T |  |  |  |  |  |  | Diodes Inc | DMG1012T | MOSFET, N, LOW VT, LOGIC
21 | 8 | R1,R4,R5,R6,R7,R8,R19,R31 | 0R |  |  | 0.1W |  | 2012 | 1% | Generic | Generic | RES, CHIP, 2012, 1%, 0.25W 0R
22 | 7 | R2,R18,R26,R27,R28,R29, R10 | 100K |  |  | 63mW |  | 1005 | 1% | Generic | Generic | RES, CHIP, 1005, 100K, 1%, 0.063W
23 | 2 | R3,R9 | 470R |  |  | 63mW |  | 1005 | 1% | Generic | Generic | RES, CHIP, 1005, 470R, 1%, 0.063W
24 | 3 | R20,R21,R30 | 47K |  |  | 63mW |  | 1005 | 1% | Generic | Generic | RES, CHIP, 1005, 47K, 1%, 0.063W
25 | 2 | R12 | 1K |  |  | 63mW |  | 1005 | 1% | Generic | Generic | RES, CHIP, 1005, 1K, 1%, 0.063W
26 | 4 | R13,R14,R16,R17 | 1.8K |  |  | 63mW |  | 1005 | 1% | Generic | Generic | RES, CHIP, 1005, 1.8K, 1%, 0.063W
27 | 1 | R15 | NO FIT |  |  | 63mW |  | 1005 | 1% | Generic | Generic | RES, CHIP, 1005, 27K, 1%, 0.063W
28 | 1 | R22 | 0R |  |  |  |  | 1005 |  | Generic | Generic | RES, CHIP, 1005, 0R
29 | 1 | R23 | 0R |  |  |  |  | 1005 |  | Generic | Generic | RES, CHIP, 1005, 0R
30 | 1 | U1 | RT8020AGQW (Z00) |  |  |  |  |  |  | Richtek | RT8020AGQW (Z00) | IC, SMT, Dual SMPS, V1=3V3, V2=1V8
31 | 1 | U2 | AP7115-25SEG |  |  |  |  | SOT323 |  | Diodes Inc | AP7115-25SEG-7 | IC, LDO, 2.5V, 150mA SOT-25
32 | 1 | U3 | AP2331W |  |  |  |  |  |  | Diodes | AP2331W | Current limited load switch, 200mA
33 | 1 | U4 | ESD5384 |  |  |  |  |  |  | ON Semiconductor | ESD5384 | IC, ESD, HDMI CONTROL
34 | 1 | U5 | FSUSB42UMX |  |  |  |  |  |  | Fairchild | FSUSB42UMX | USB 2.0 SWITCH
35 | 2 | R24,R25 | NO FIT |  |  |  |  |  |  | Generic | Generic | RES, CHIP, 1005
36 | 1 | J3 | 6W 0.1" PIN HDR |  |  |  |  |  |  | Generic | Generic | 2x3W 0.1" pin header (2 rows x3)
37 | 3 | SHUNT/JUMPER |  |  |  |  |  |  |  | TE | 382811-6 | 2x shunt fitted to J3 (3V3) and J4 (EN)
38 | 1 | RPI-CMIO-V3_0 PCB |  |  |  |  |  |  |  |  |  | Printed Circuit Board
