wmarchewka/class_4_test/docs/MAINBOARD_TEST_POINTS.xlsx

 | Signal | GND | GND TP |  | Signal | GND | GND TP |  | Signal | GND | GND TP
TP1 | PRIMARY FREQ AMPLIFIED | GND | TP4 | TP1 | PRIMARY FREQ AMPLIFIED | GND | TP4 | TP15 | GND
TP2 | SECONDARY FREQ AMPLIFIED | GND | TP4 | TP2 | SECONDARY FREQ AMPLIFIED | GND | TP4 | TP9 | GND_A
TP3 | PRIMARY FREQ | GND | TP4 | TP3 | PRIMARY FREQ | GND | TP4 | TP17 | GND_A
TP4 | PRIMARY FREQ GND | GND |  | TP4 | PRIMARY FREQ GND | GND |  | TP12 | GND_B
TP5 | SECONDARY FREQUENCY | GND | TP6 | TP5 | SECONDARY FREQUENCY | GND | TP6 | TP19 | GND_B
TP6 | SEONDARY FREQ GND | GND |  | TP6 | SEONDARY FREQ GND | GND
TP7 | +15V_A | GND_A | TP9 | TP13 | +15V_C | GND | TP15
TP8 | +3.3V_A | GND_A | TP9 | TP14 | +3.3V | GND | TP15
TP9 | GND_A |  |  | TP15 | GND
TP10 | +15V_B | GND_B | TP12 | TP22 | 3.3V_RASPI | GND | TP15
TP11 | +3.3V_B | GND_B | TP12 | TP23 | BCM19_MISO1 | GND | TP15
TP12 | GND_B |  |  | TP24 | BMC21_SCK1 | GND | TP6
TP13 | +15V_C | GND | TP15 | TP25 | BMC20_MOSI1 | GND | TP6
TP14 | +3.3V | GND | TP15 | TP32 | BCM7_CE1 | GND | TP15
TP15 | GND |  |  | TPA1 | CODERATE | GND | TP6
TP16 | SPEED TACH 1 | GND_A | TP17 | TPA2 | CODERATE | GND | TP6
TP17 | GND_A |  |  | TPA3 | CODERATE | GND | TP6
TP18 | SPEED TACH 2 | GND_B | TB19 | TPA4 | CODERATE | GND | TP6
TP19 | GND_B |  |  | TP7 | +15V_A | GND_A | TP9
TP20 | SPEED TACH 1 AMPLIFIED | GND_A | TP17 | TP8 | +3.3V_A | GND_A | TP9
TP21 | SPEED TACH 2 AMPLIFIED | GND_B | TP19 | TP9 | GND_A
TP22 | 3.3V_RASPI | GND | TP15 | TP16 | SPEED TACH 1 | GND_A | TP17
TP23 | BCM19_MISO1 | GND | TP15 | TP17 | GND_A
TP24 | BMC21_SCK1 | GND | TP6 | TP20 | SPEED TACH 1 AMPLIFIED | GND_A | TP17
TP25 | BMC20_MOSI1 | GND | TP6 | TPA5 | SPEED 1 OPAMP IN | GND_A | TP17
TP26 | SCK2_TACH1 | GND_B | TP6 | TPA6 | SPEED 1 OPAMP OUT | GND_A | TP17
TP27 | MOSI2_TACH1 | GND_B | TP6 | TP10 | +15V_B | GND_B | TP12
TP28 | CS_TACH1 | GND_B | TP6 | TP11 | +3.3V_B | GND_B | TP12
TP29 | SCK2_TACH2 | GND_B | TP6 | TP12 | GND_B
TP30 | MOSI2_TACH2 | GND_B | TP6 | TP18 | SPEED TACH 2 | GND_B | TB19
TP31 | CS_TACH2 | GND_B | TP6 | TP19 | GND_B
TP32 | BCM7_CE1 | GND | TP15 | TP21 | SPEED TACH 2 AMPLIFIED | GND_B | TP19
TPA1 | CODERATE | GND | TP6 | TP26 | SCK2_TACH1 | GND_B | TP6
TPA2 | CODERATE | GND | TP6 | TP27 | MOSI2_TACH1 | GND_B | TP6
TPA3 | CODERATE | GND | TP6 | TP28 | CS_TACH1 | GND_B | TP6
TPA4 | CODERATE | GND | TP6 | TP29 | SCK2_TACH2 | GND_B | TP6
TPA5 | SPEED 1 OPAMP IN | GND_A | TP17 | TP30 | MOSI2_TACH2 | GND_B | TP6
TPA6 | SPEED 1 OPAMP OUT | GND_A | TP17 | TP31 | CS_TACH2 | GND_B | TP6
TPA5 | SPEED 2 OPAMP IN | GND_B | TP19 | TPA5 | SPEED 2 OPAMP IN | GND_B | TP19
TPA6 | SPEED 2 OPAMP OUT | GND_B | TP19 | TPA6 | SPEED 2 OPAMP OUT | GND_B | TP19
