wmarchewka/class_4_test/docs/D3005H100-A/D3005H100_A-TOP.dxf

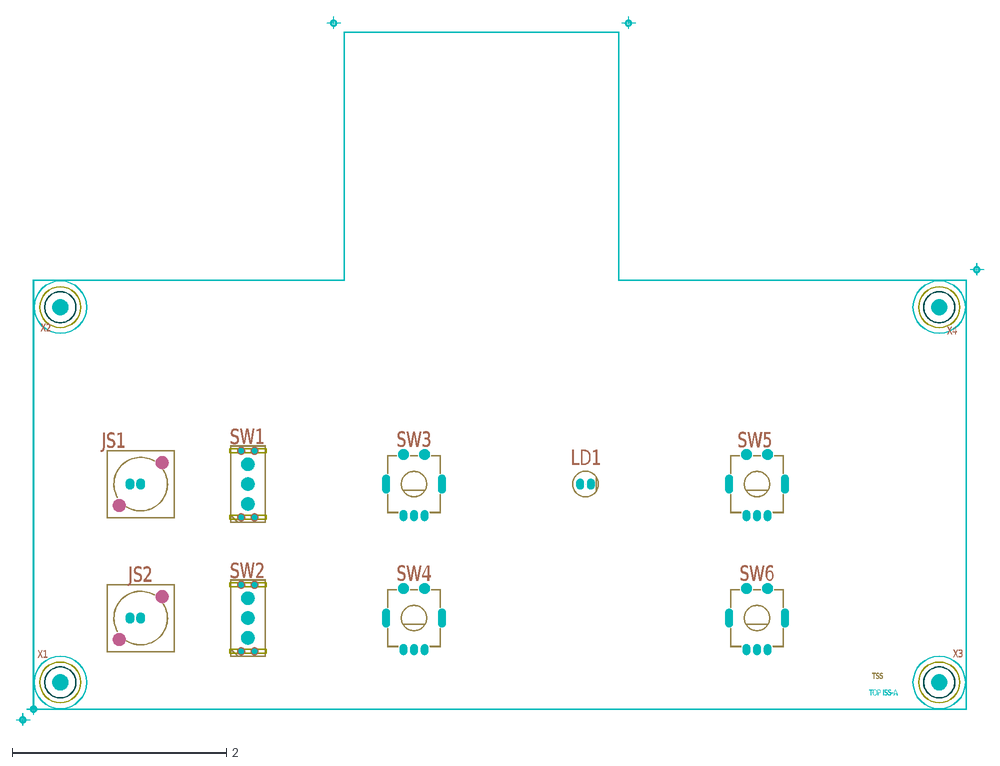
[picture p6: CAD file, 2020-03-05]
docs/D3005H100-A/D3005H100_A-TOP.dxf
TOP ISS-A
TSS
JS1
JS2
LD1
SW3
SW4
SW5
SW6
SW1
SW2
X1
X2
X3
X4
