wmarchewka/class_4_test/docs/D3005H100-A/D3005H100_A-BOT.dxf

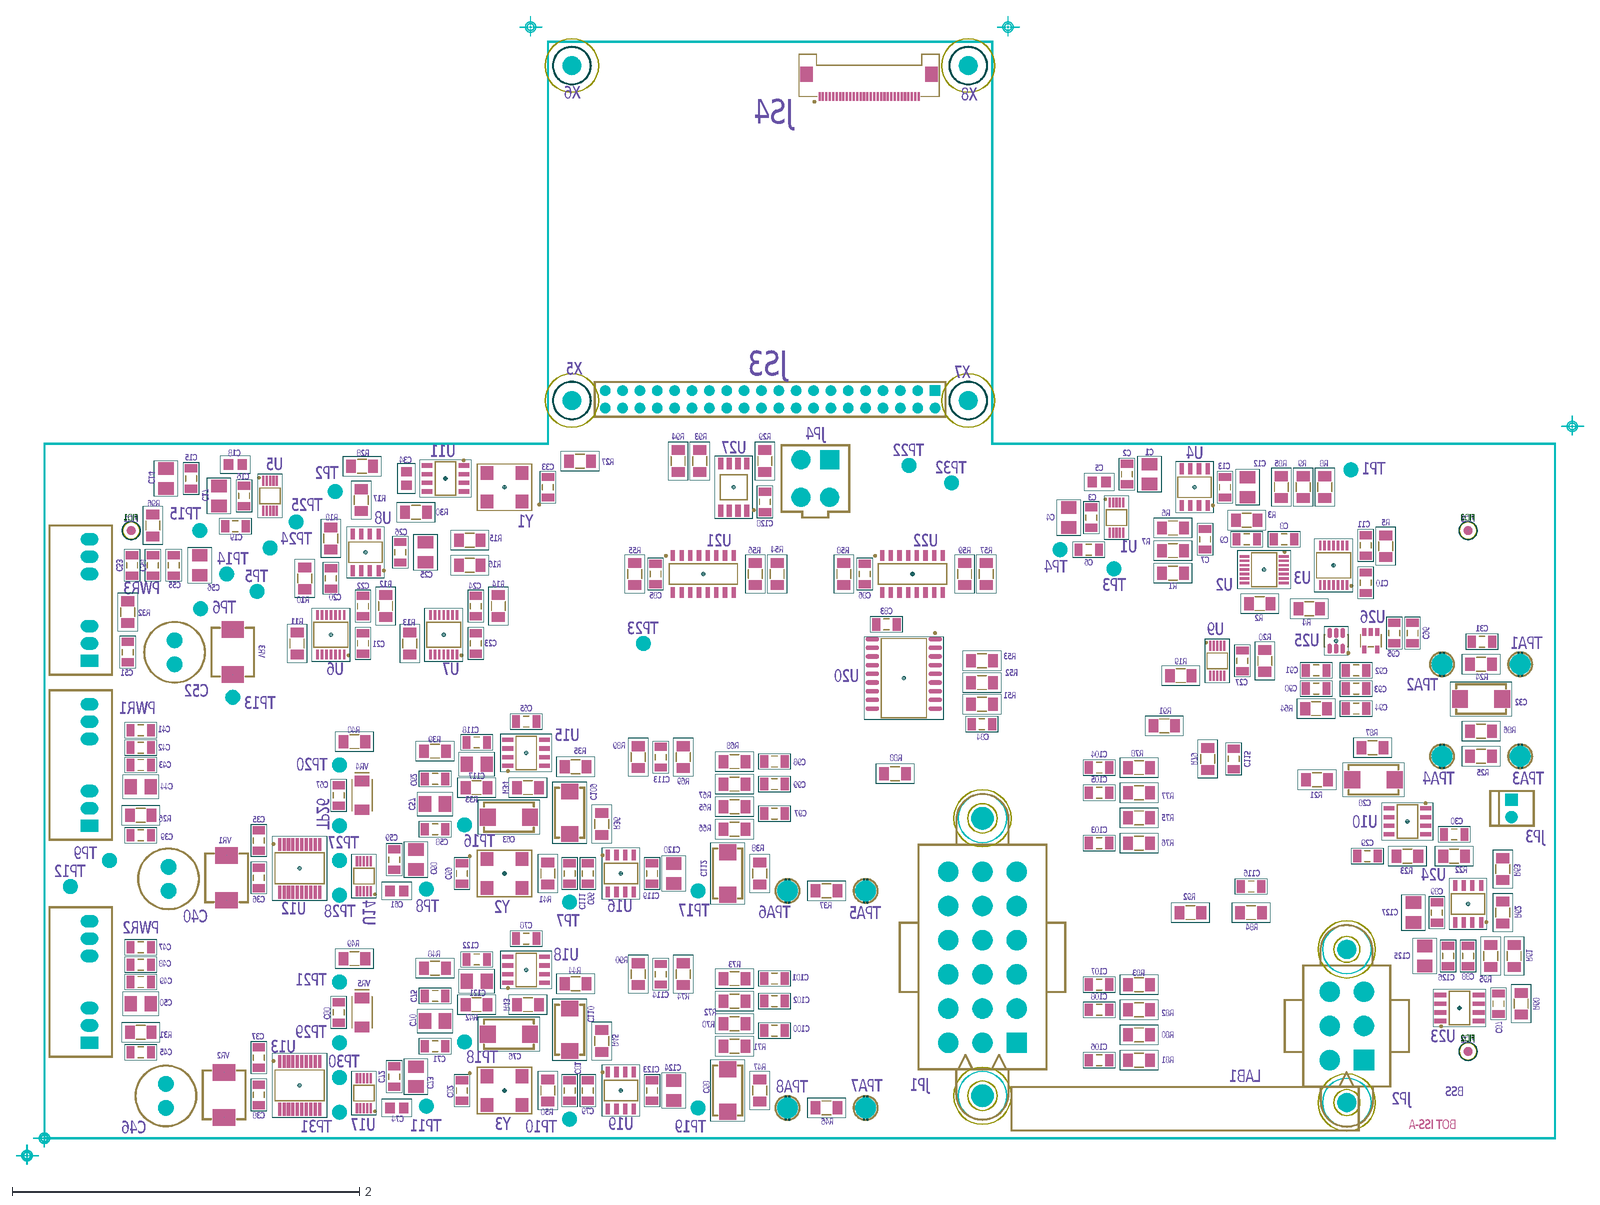
[picture p7: CAD file, 2020-03-05]
docs/D3005H100-A/D3005H100_A-BOT.dxf
BSS
BOT ISS-A
C40
C46
C52
C18
C34
C5
C61
C74
C20
C7
C90
C19
C31
C6
C62
C75
C10
C11
C118
C119
C122
C123
C126
C13
C15
C16
C2
C21
C22
C23
C24
C26
C27
C29
C3
C30
C33
C35
C36
C37
C38
C58
C59
C65
C66
C67
C69
C71
C72
C78
C79
C8
C80
C82
C83
C84
C85
C86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
