wmarchewka/class_4_test/docs/Compute Module/Board Design/RPI-CMIO-V3_0-PUBLIC-SCHEMATIC.pdf

# CONTENTS:

# PAGE1 - CONTENTS

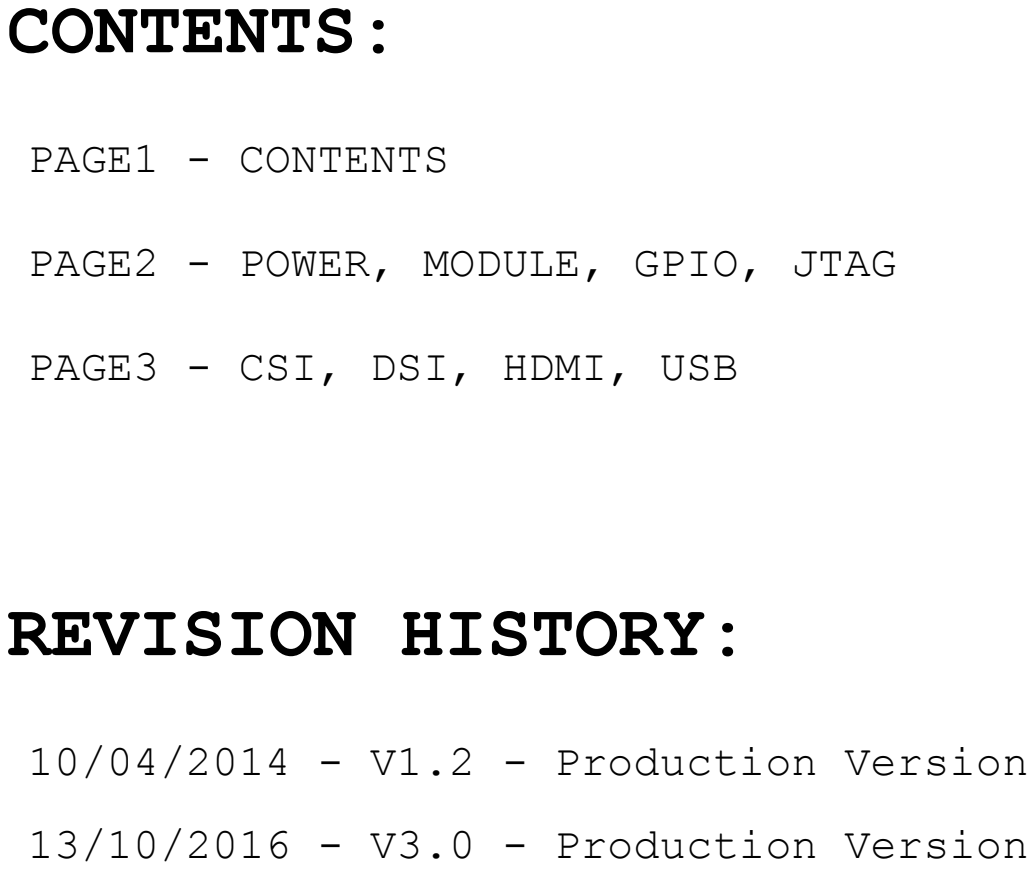
[picture p8: page 1]
REVISION HISTORY:; 10/04/2014 - V1.2 - Production Version; 13/10/2016 - V3.0 - Production Version; Title; Size; Ref; Rev; Date:; Sheet; Drawn By; James Adams; RPI-CMIO; Thursday, October 13, 2016

PAGE2 - POWER, MODULE, GPIO, JTAG

PAGE3 - CSI, DSI, HDMI, USB

© Raspberry Pi 2015
www.raspberrypi.org

Raspberry Pi Compute Module IO Board

# POWER LED

# POWER IN

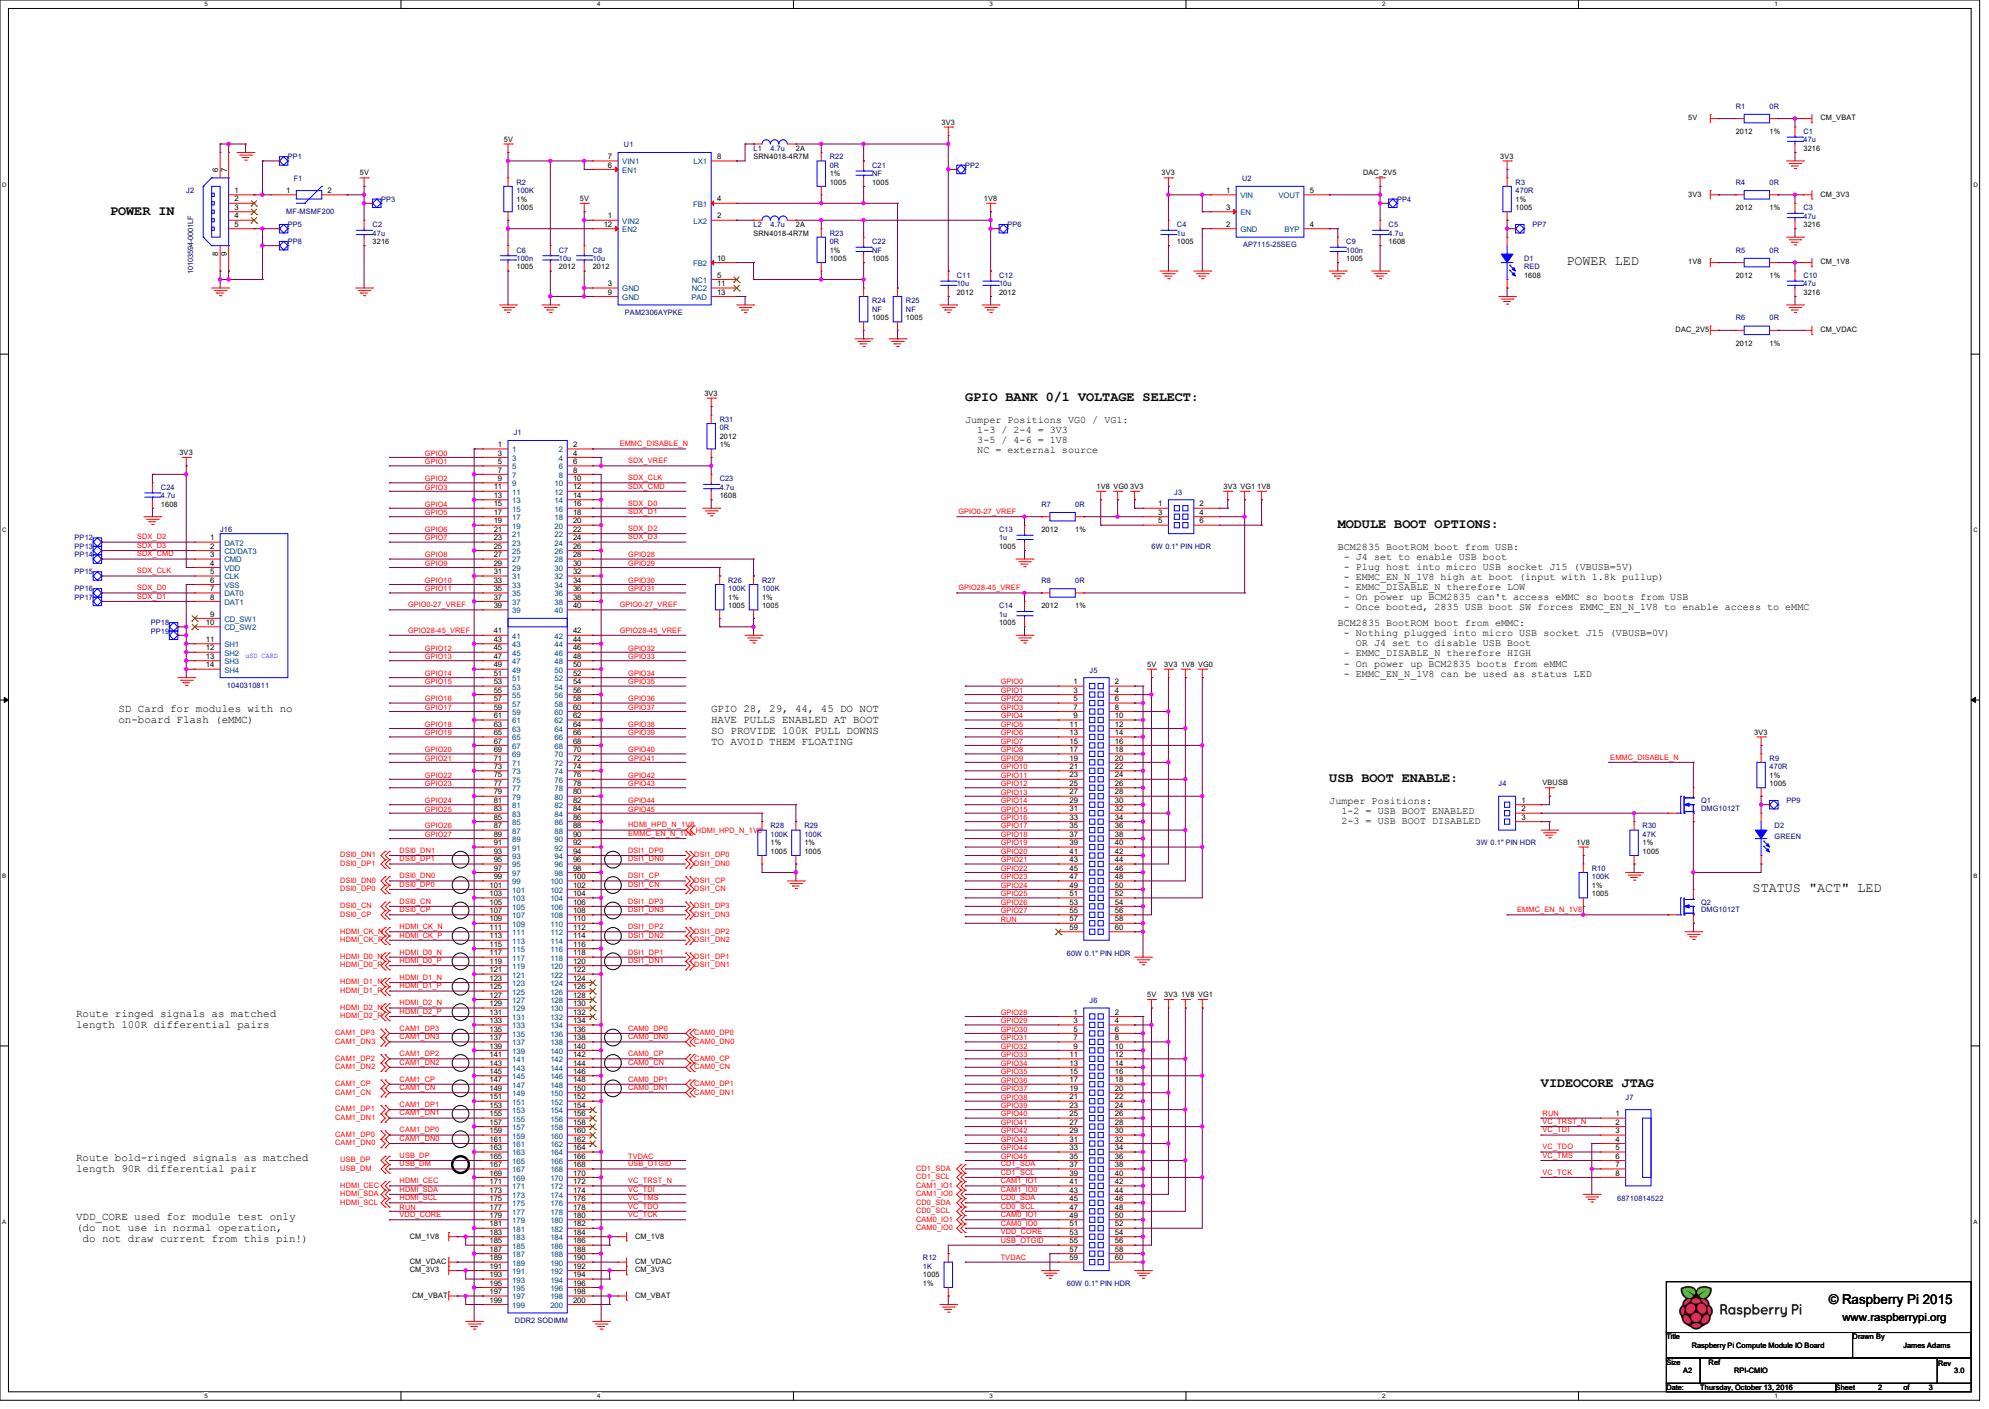
[picture p9: page 2]

GPIO BANK 0/1 VOLTAGE SELECT:

1040310811 DAT2 1 CD/DAT3 2 CMD 3 VDD 4 CLK 5 VSS 6 DAT0 7 DAT1 8 CD_SW1 9 CD_SW2 10 SH1 11 SH2 12 SH3 13 SH4 14

BCM2835 BootROM boot from USB:
- J4 set to enable USB boot
- Plug host into micro USB socket J15 (VBUSB=5V)
- EMMC_EN_N_1V8 high at boot (input with 1.8k pullup)
- EMMC_DISABLE_N therefore LOW
- On power up BCM2835 can't access eMMC so boots from USB
- Once booted, 2835 USB boot SW forces EMMC_EN_N_1V8 to enable access to eMMC
BCM2835 BootROM boot from eMMC:
- Nothing plugged into micro USB socket J15 (VBUSB=0V)
OR J4 set to disable USB Boot
- EMMC_DISABLE_N therefore HIGH
- On power up BCM2835 boots from eMMC
- EMMC_EN_N_1V8 can be used as status LED

SD Card for modules with no
on-board Flash (eMMC)

GPIO 28, 29, 44, 45 DO NOT
HAVE PULLS ENABLED AT BOOT
SO PROVIDE 100K PULL DOWNS
TO AVOID THEM FLOATING

Route ringed signals as matched
length 100R differential pairs

Route bold-ringed signals as matched
length 90R differential pair

VDD_CORE used for module test only
(do not use in normal operation,
do not draw current from this pin!)

© Raspberry Pi 2015 Drawn By

# CAM0

# DISP0

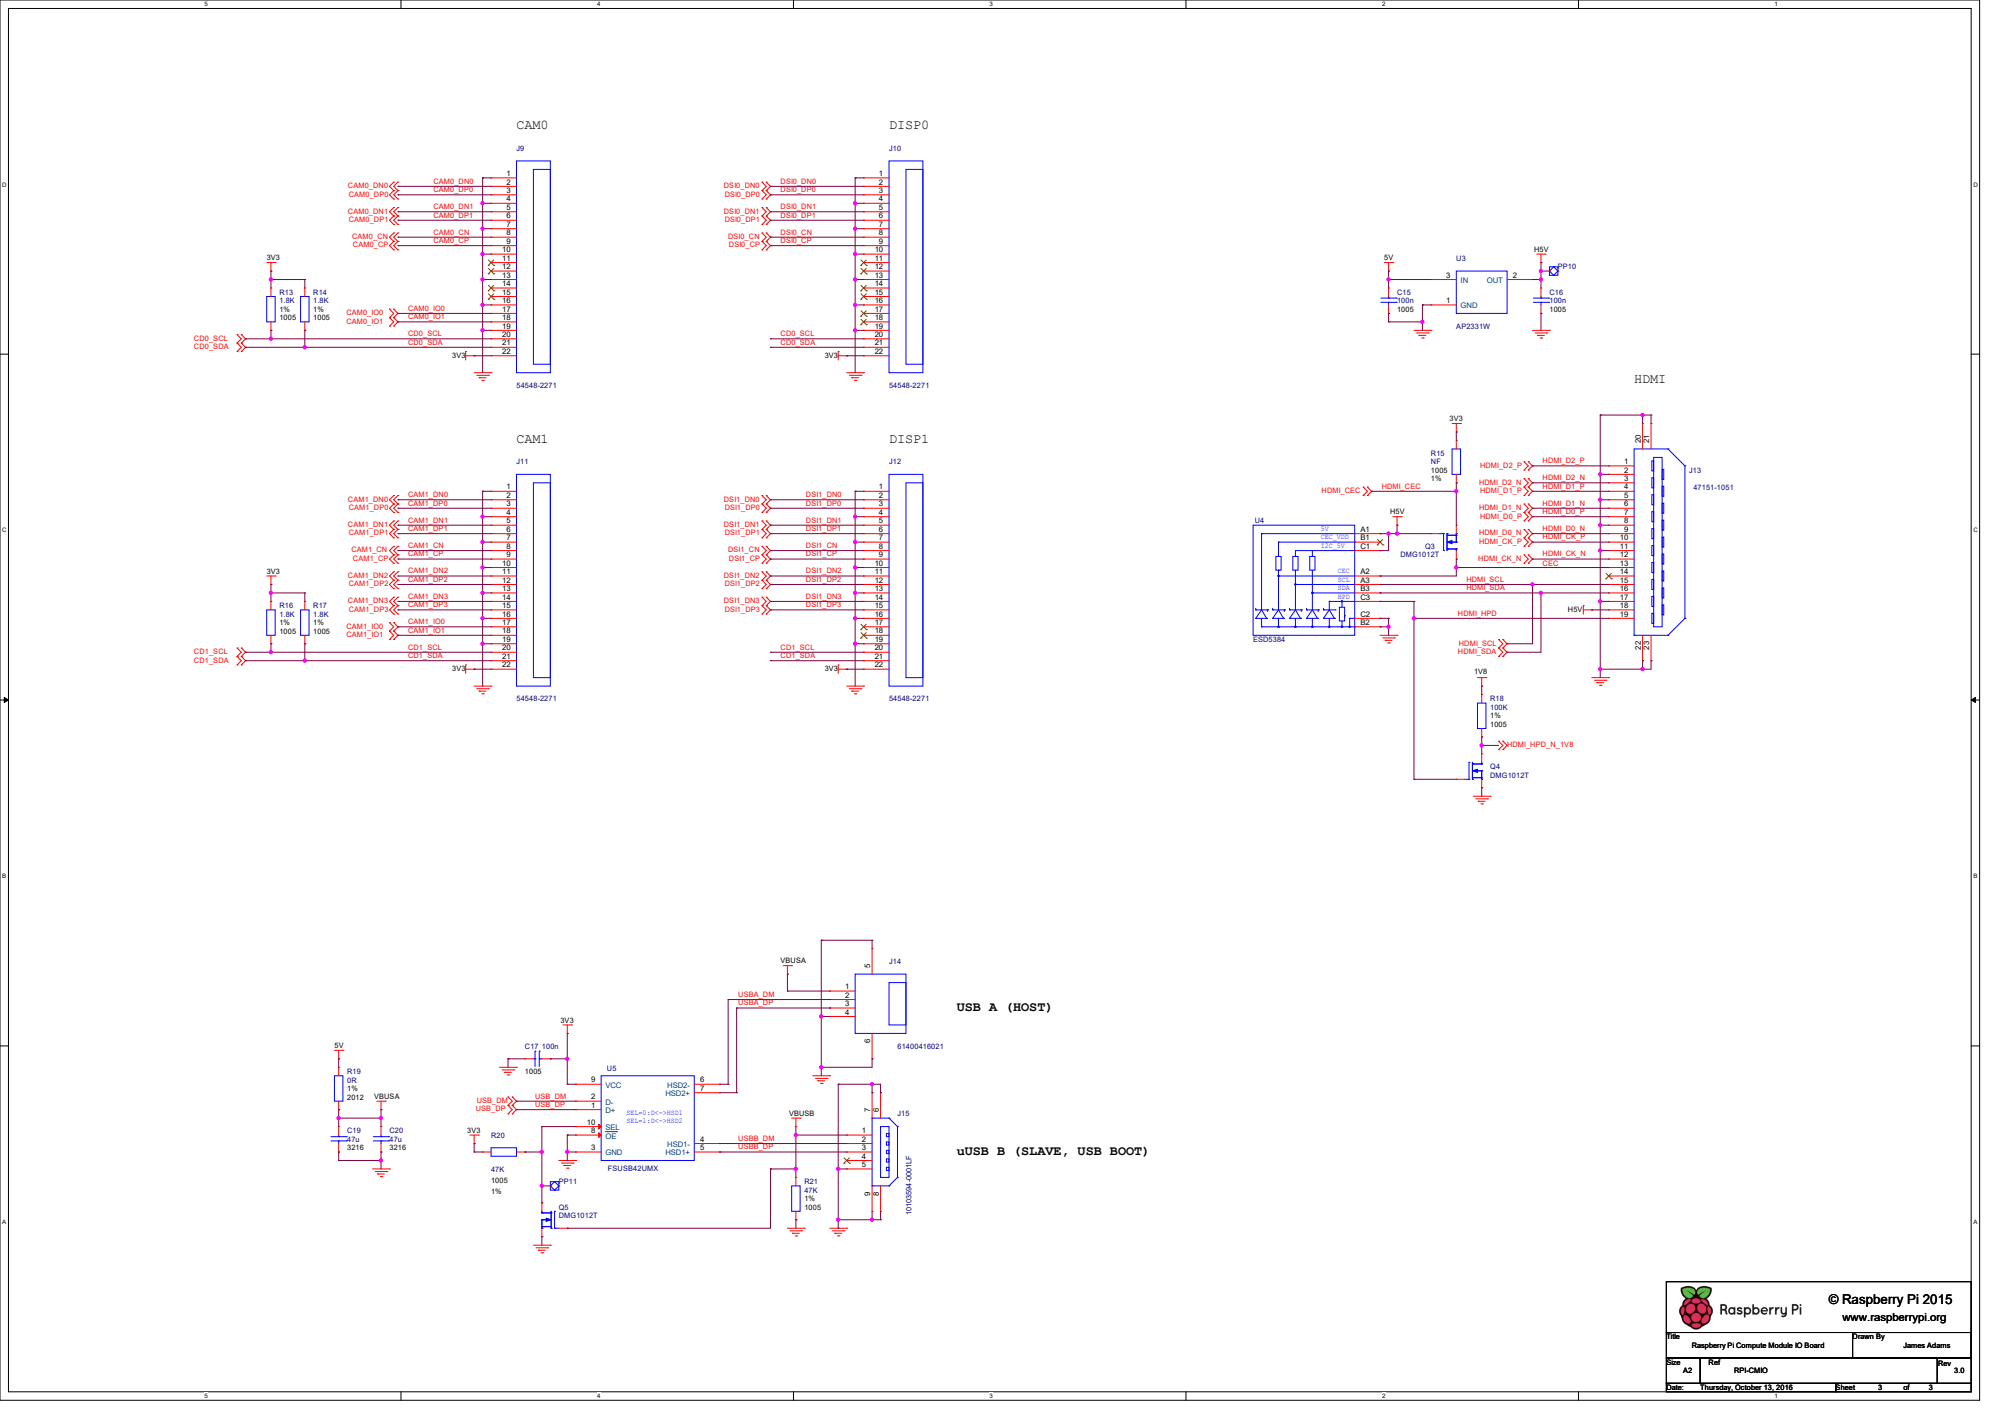
[picture p10: page 3]

SCL
SDA | | 16
HPD | | | 17

2 3 4 5

uUSB B (SLAVE, USB BOOT)

© Raspberry Pi 2015 Drawn By
