wmarchewka/class_4_test/docs/D3005H100S1BR0.pdf

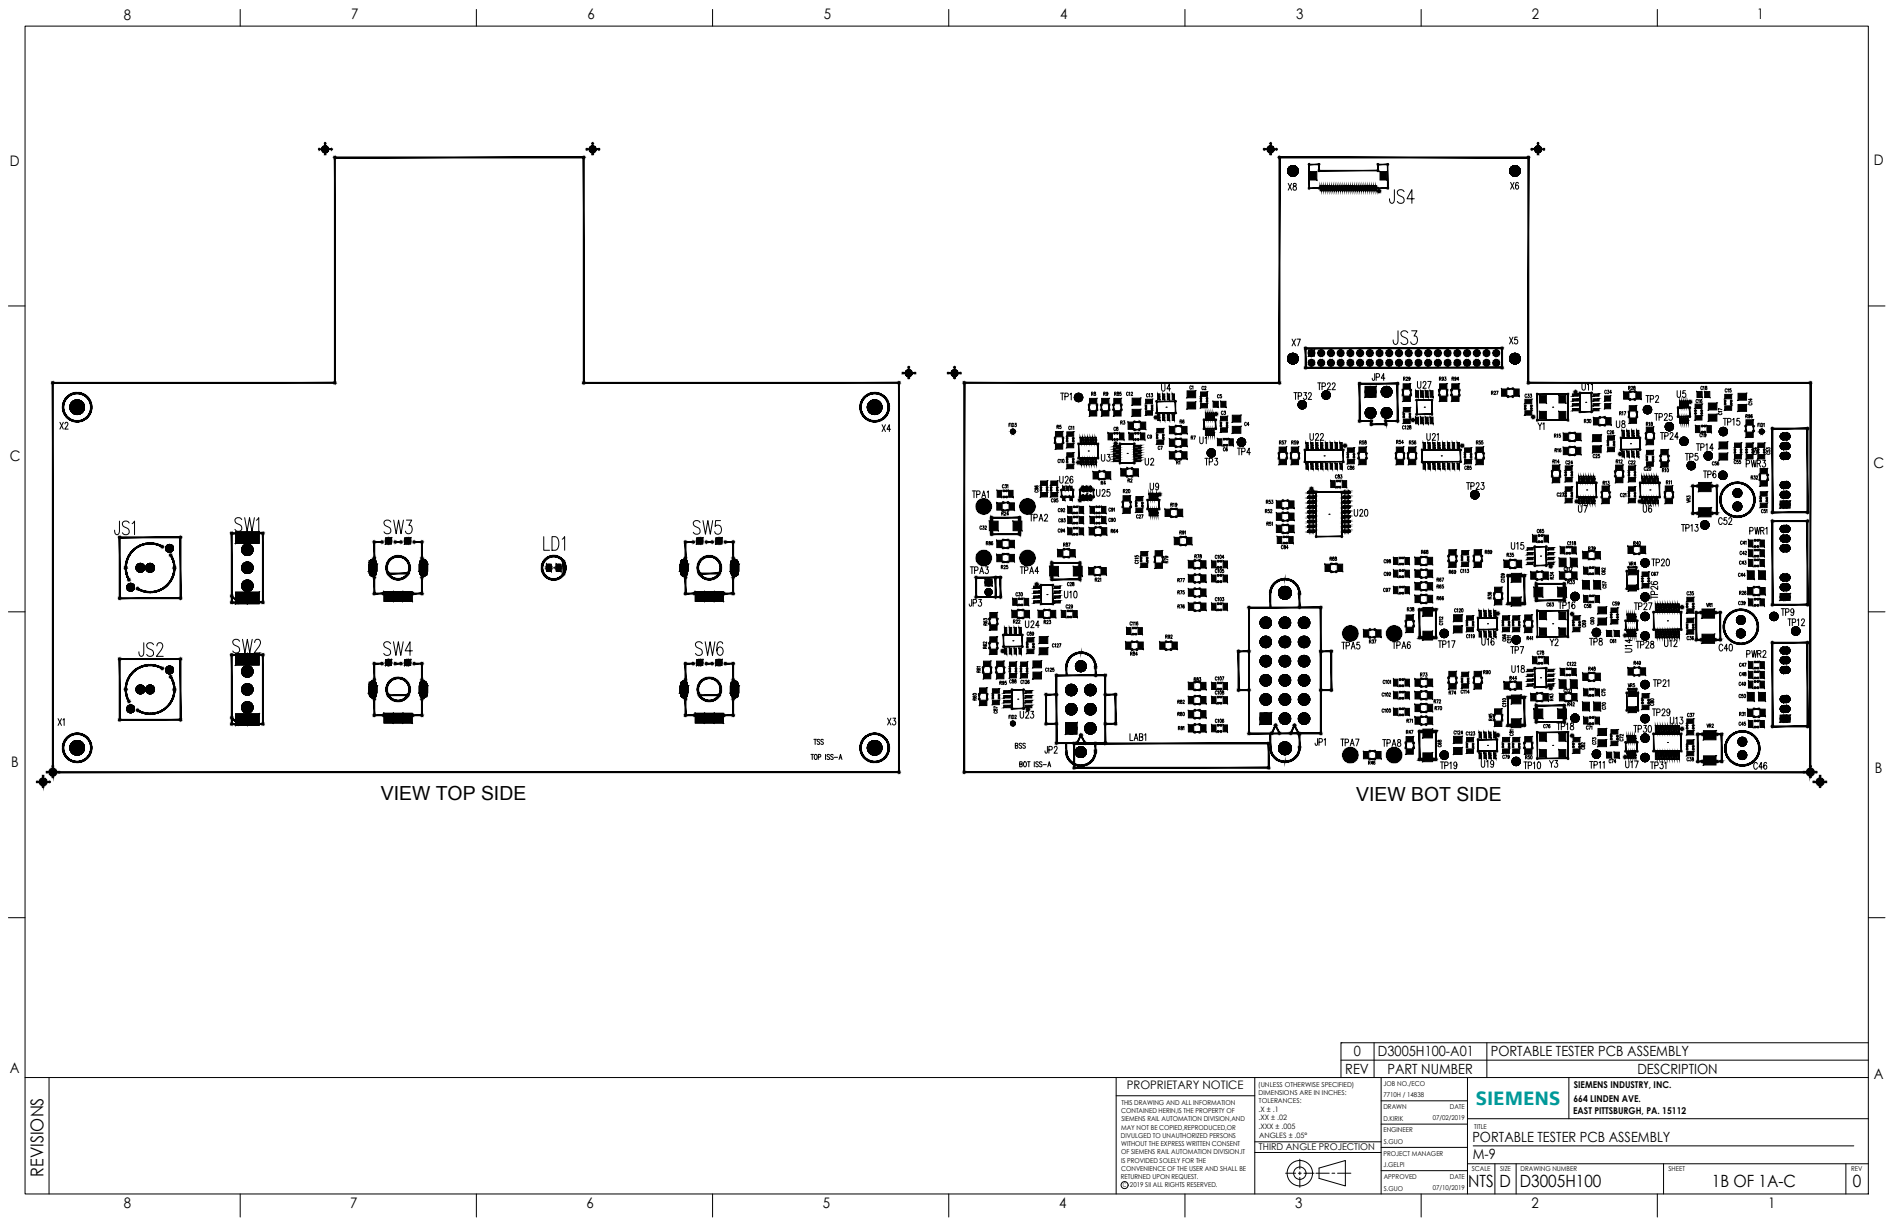
[picture p11: page 1]
PROPRIETARY NOTICE; REV; PART NUMBER; DESCRIPTION; PORTABLE TESTER PCB ASSEMBLY; SCALE; DRAWING NUMBER; JOB NO./ECO; PROJECT MANAGER; NTS; VIEW TOP SIDE; VIEW BOT SIDE

(UNLESS OTHERWISE SPECIFIED)
DIMENSIONS ARE IN INCHES:
TOLERANCES:
.XXX ± .005
ANGLES ± .05°
THIRD ANGLE PROJECTION

SIEMENS INDUSTRY, INC.
664 LINDEN AVE.
EAST PITTSBURGH, PA. 15112

THIS DRAWING AND ALL INFORMATION
CONTAINED HERIN,IS THE PROPERTY OF
SIEMENS RAIL AUTOMATION DIVISION,AND
MAY NOT BE COPIED,REPRODUCED,OR
DIVULGED TO UNAUTHORIZED PERSONS
WITHOUT THE EXPRESS WRITTEN CONSENT
OF SIEMENS RAIL AUTOMATION DIVISION.IT
IS PROVIDED SOLELY FOR THE
CONVENIENCE OF THE USER AND SHALL BE
RETURNED UPON REQUEST.
2019 SII ALL RIGHTS RESERVED.
