wmarchewka/class_4_test/docs/D3005H103_A_A01.pdf

6
5

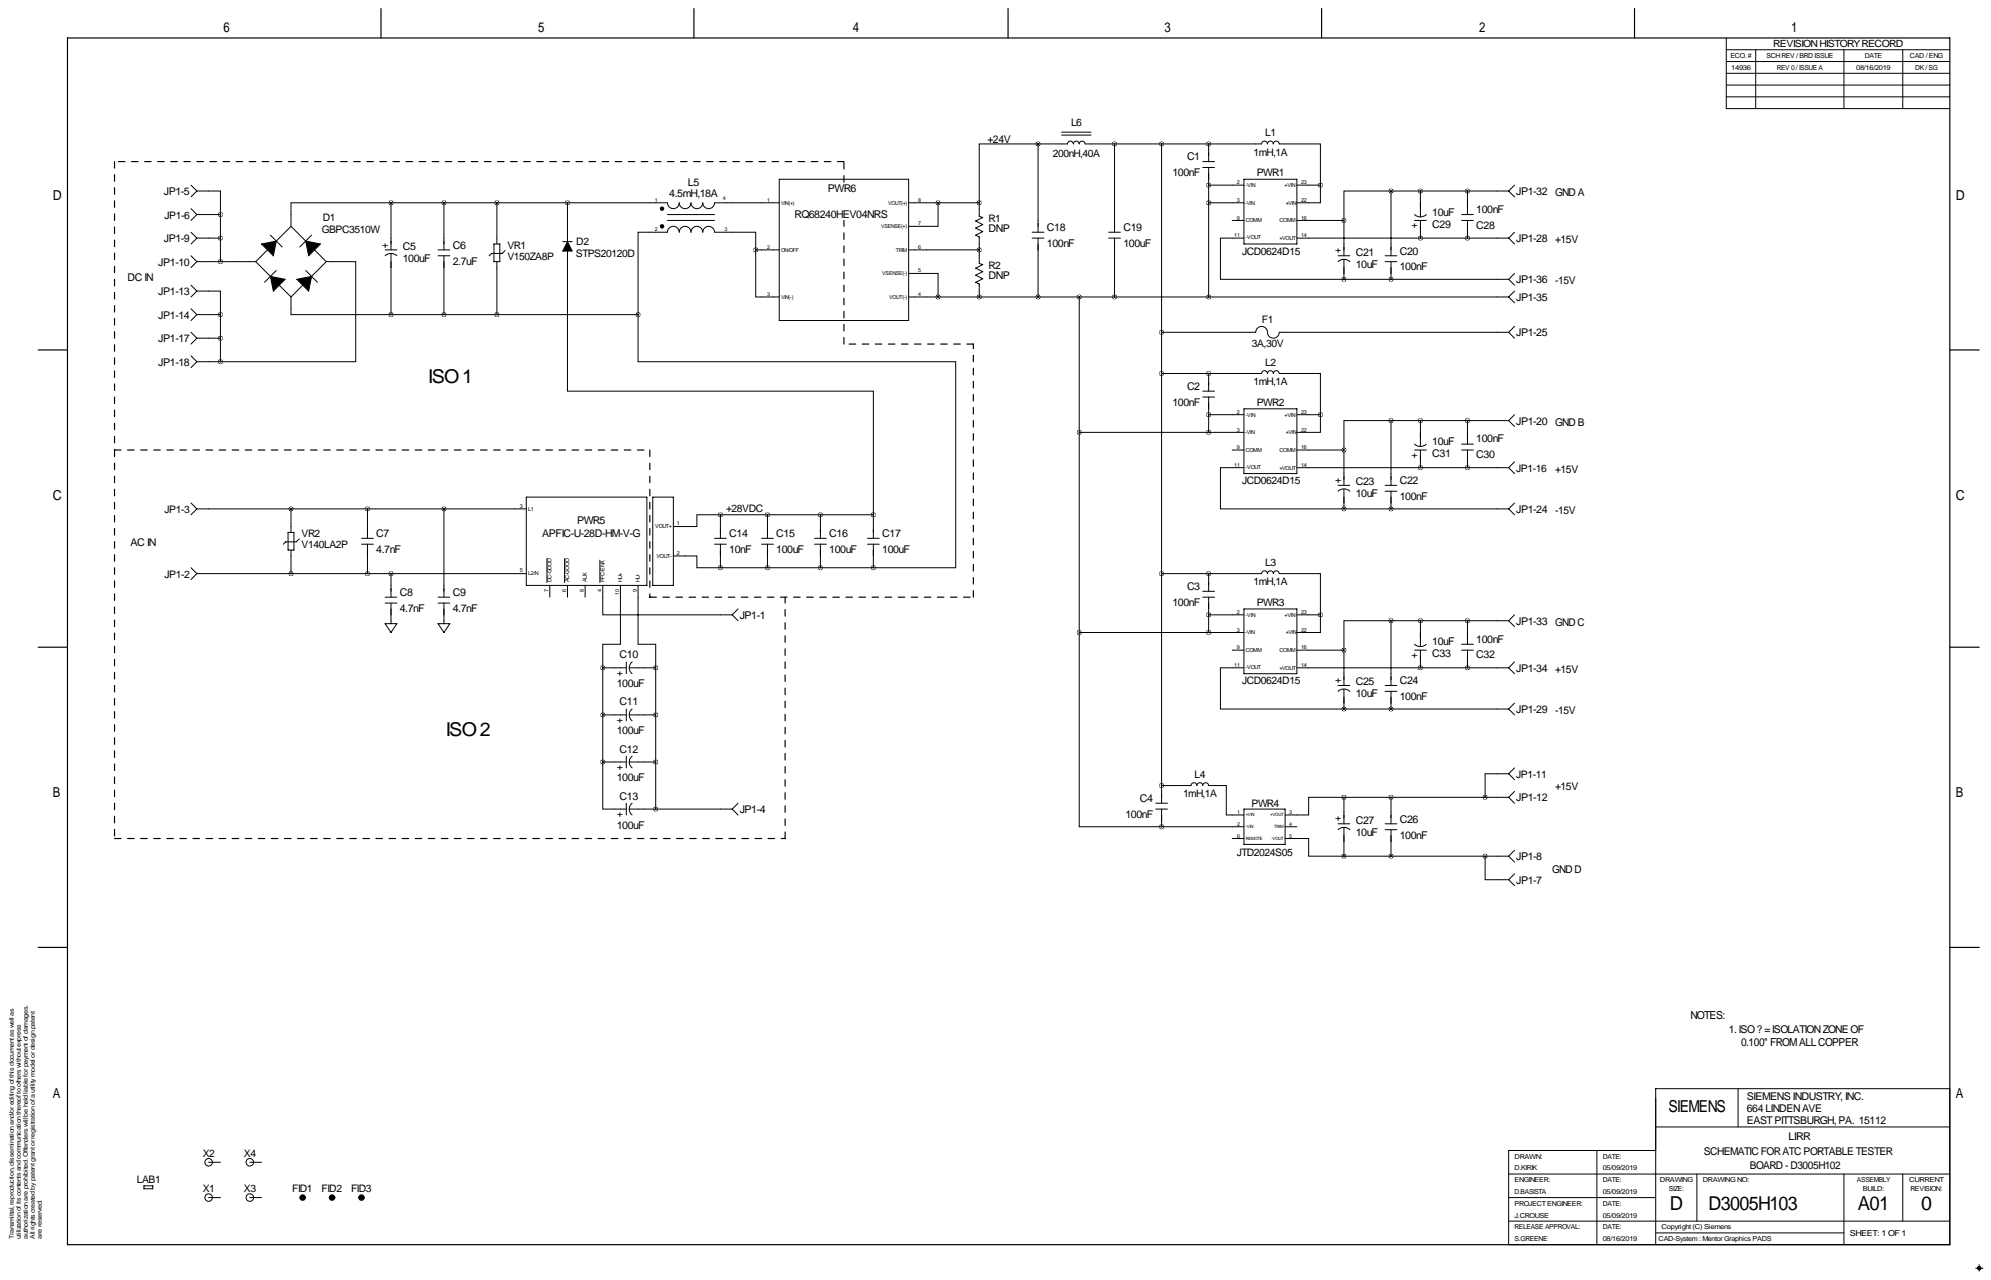
[picture p12: page 1]

SCH REV / BRD ISSUE

authorization are prohibited. Offenders will be held liable for payment of damages.

Transmittal, reproduction, dissemination and/or editing of this document as well as

All rights created by patent grant or registration of a utility model or design patent

utilization of its contents and communication thereof to others without express

1. ISO ? = ISOLATION ZONE OF
0.100" FROM ALL COPPER

SCHEMATIC FOR ATC PORTABLE TESTER

DRAWN: D.KIRIK | DATE: 05/09/2019
ENGINEER: D.BASISTA | DATE: 05/09/2019 | DRAWING SIZE: D | DRAWING NO: D3005H103 | ASSEMBLY BUILD: A01 | CURRENT REVISION: 0

PROJECT ENGINEER: J.CROUSE | DATE: 05/09/2019

RELEASE APPROVAL: S.GREENE | DATE: 08/16/2019 | Copyright (C) Siemens | | SHEET: 1 OF 1

CAD-System : Mentor Graphics PADS
