wmarchewka/class_4_test/docs/D3005H100-A/BOT SOLDERMASK.pdf

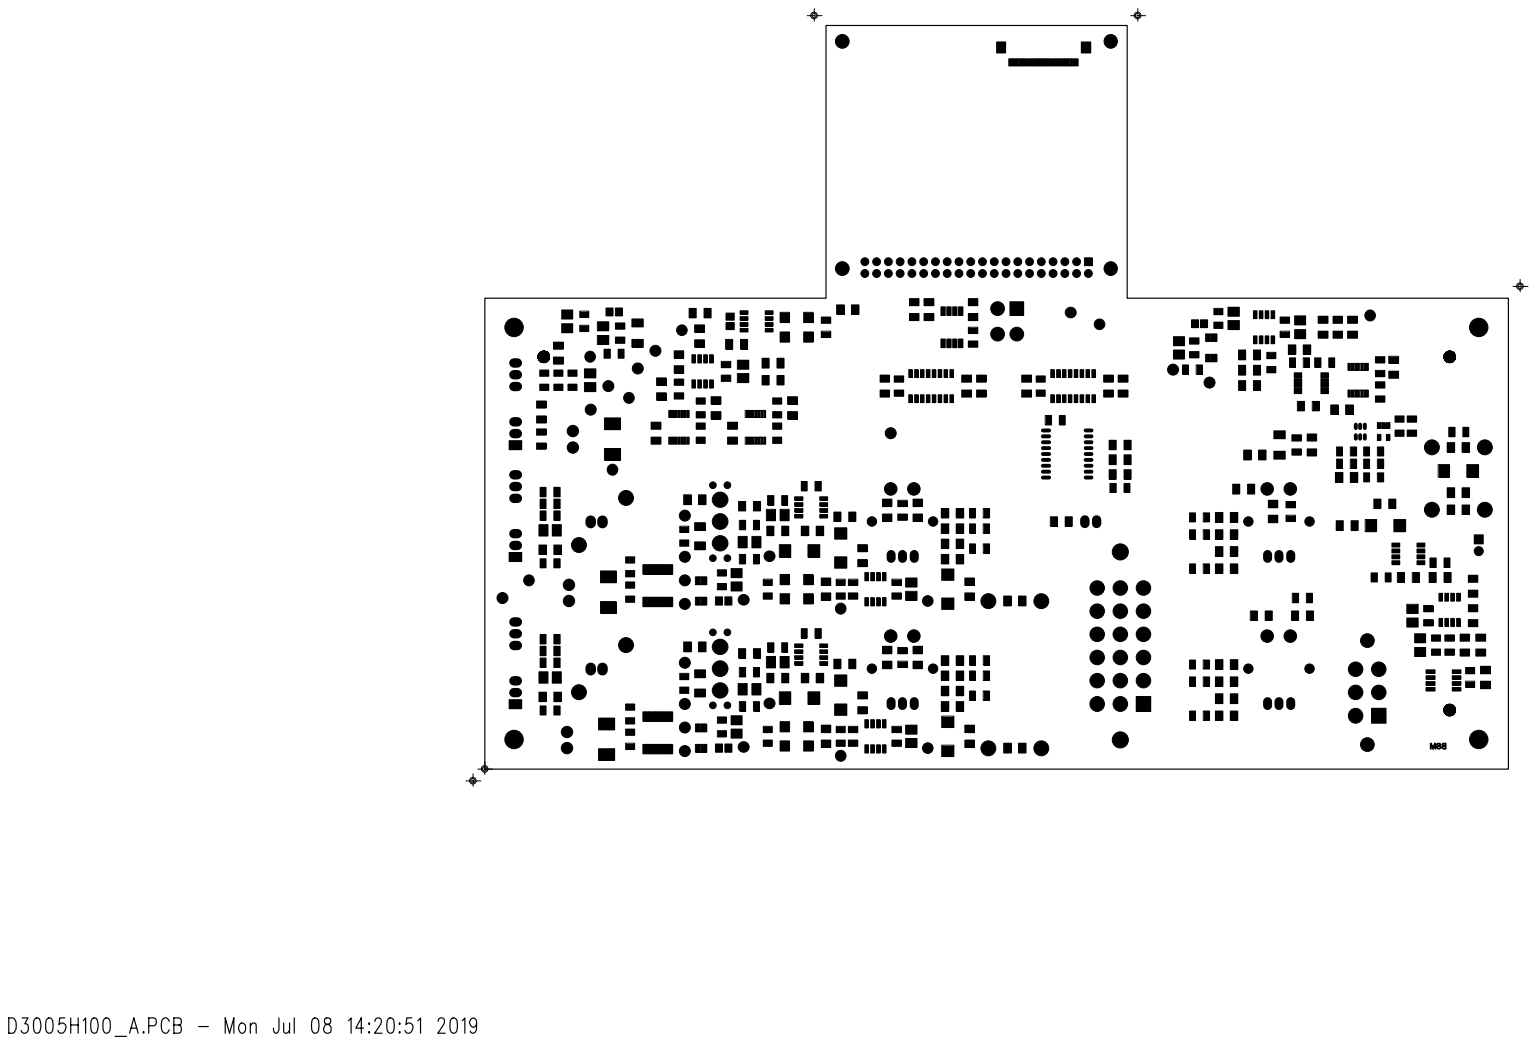
[picture p13: page 1]
