wmarchewka/class_4_test/docs/D3005H100-A/FABRICATION.pdf

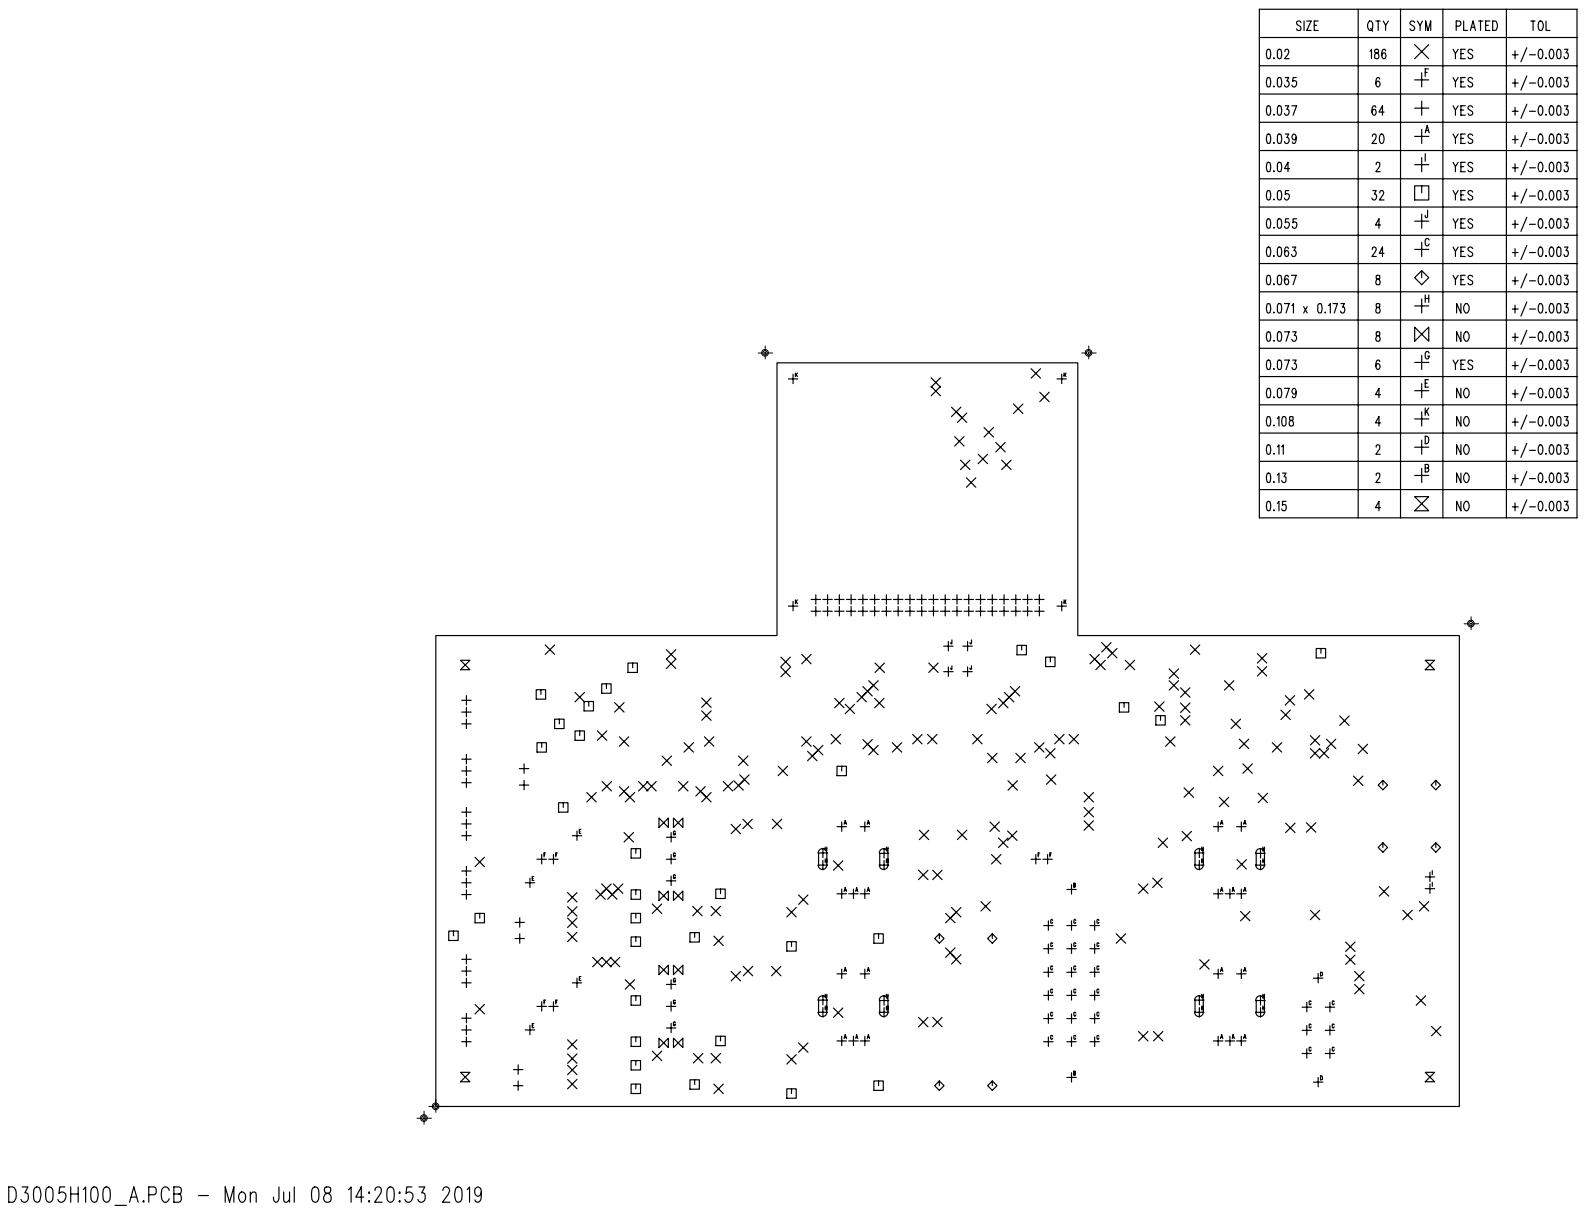
[picture p14: page 1]
