wmarchewka/class_4_test/docs/D3005H100-A/TOP SOLDERMASK.pdf

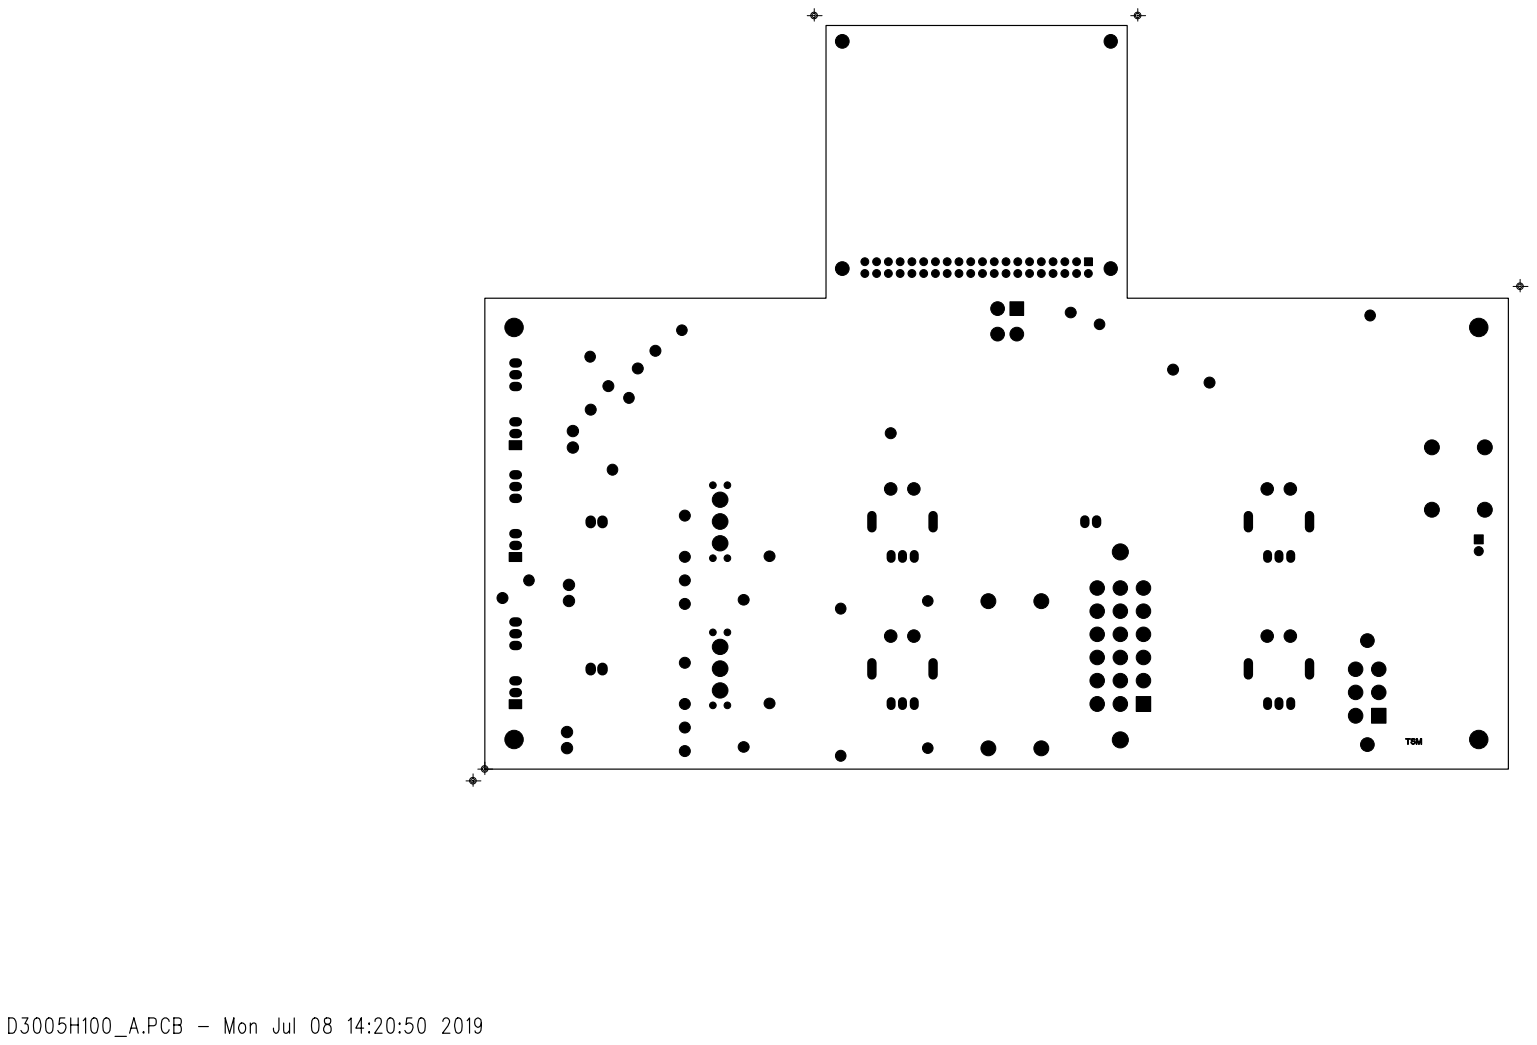
[picture p15: page 1]
