wmarchewka/class_4_test/docs/board_drawing_D3005H101_A_A01.pdf

6 | 5 | 4 | 3 | 2 | 1

D

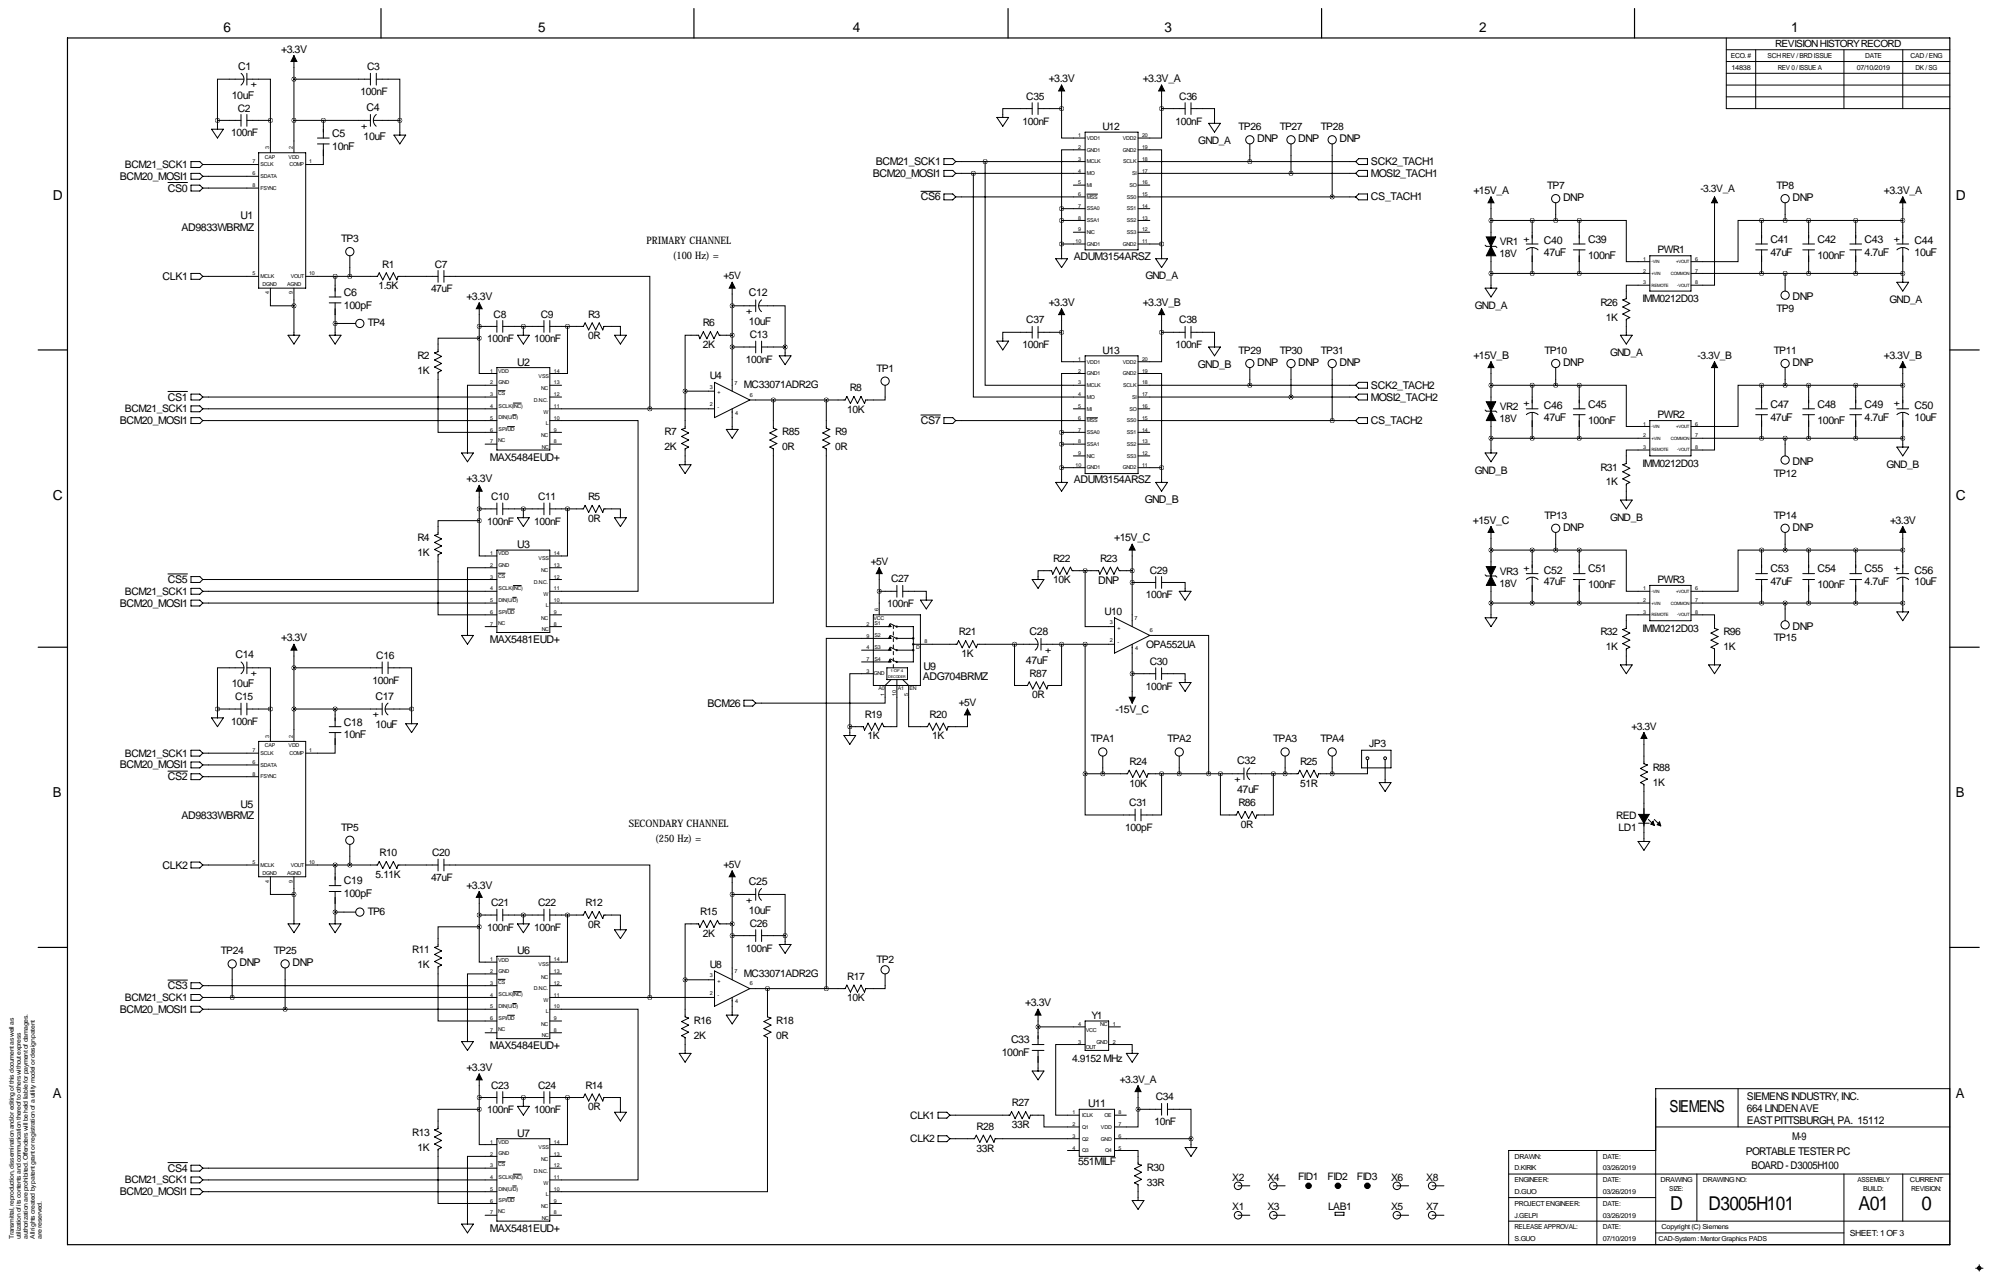
[picture p16: page 1]

SCH REV / BRD ISSUE

authorization are prohibited. Offenders will be held liable for payment of damages.

Transmittal, reproduction, dissemination and/or editing of this document as well as

All rights created by patent grant or registration of a utility model or design patent

utilization of its contents and communication thereof to others without express

DRAWN: D.KIRIK | DATE:

ENGINEER: D.GUO | | DRAWING SIZE: D | DRAWING NO: D3005H101 | ASSEMBLY BUILD: A01 | CURRENT REVISION:

PROJECT ENGINEER: J.GELPI | DATE:

CAD-System : Mentor Graphics PADS

D

D

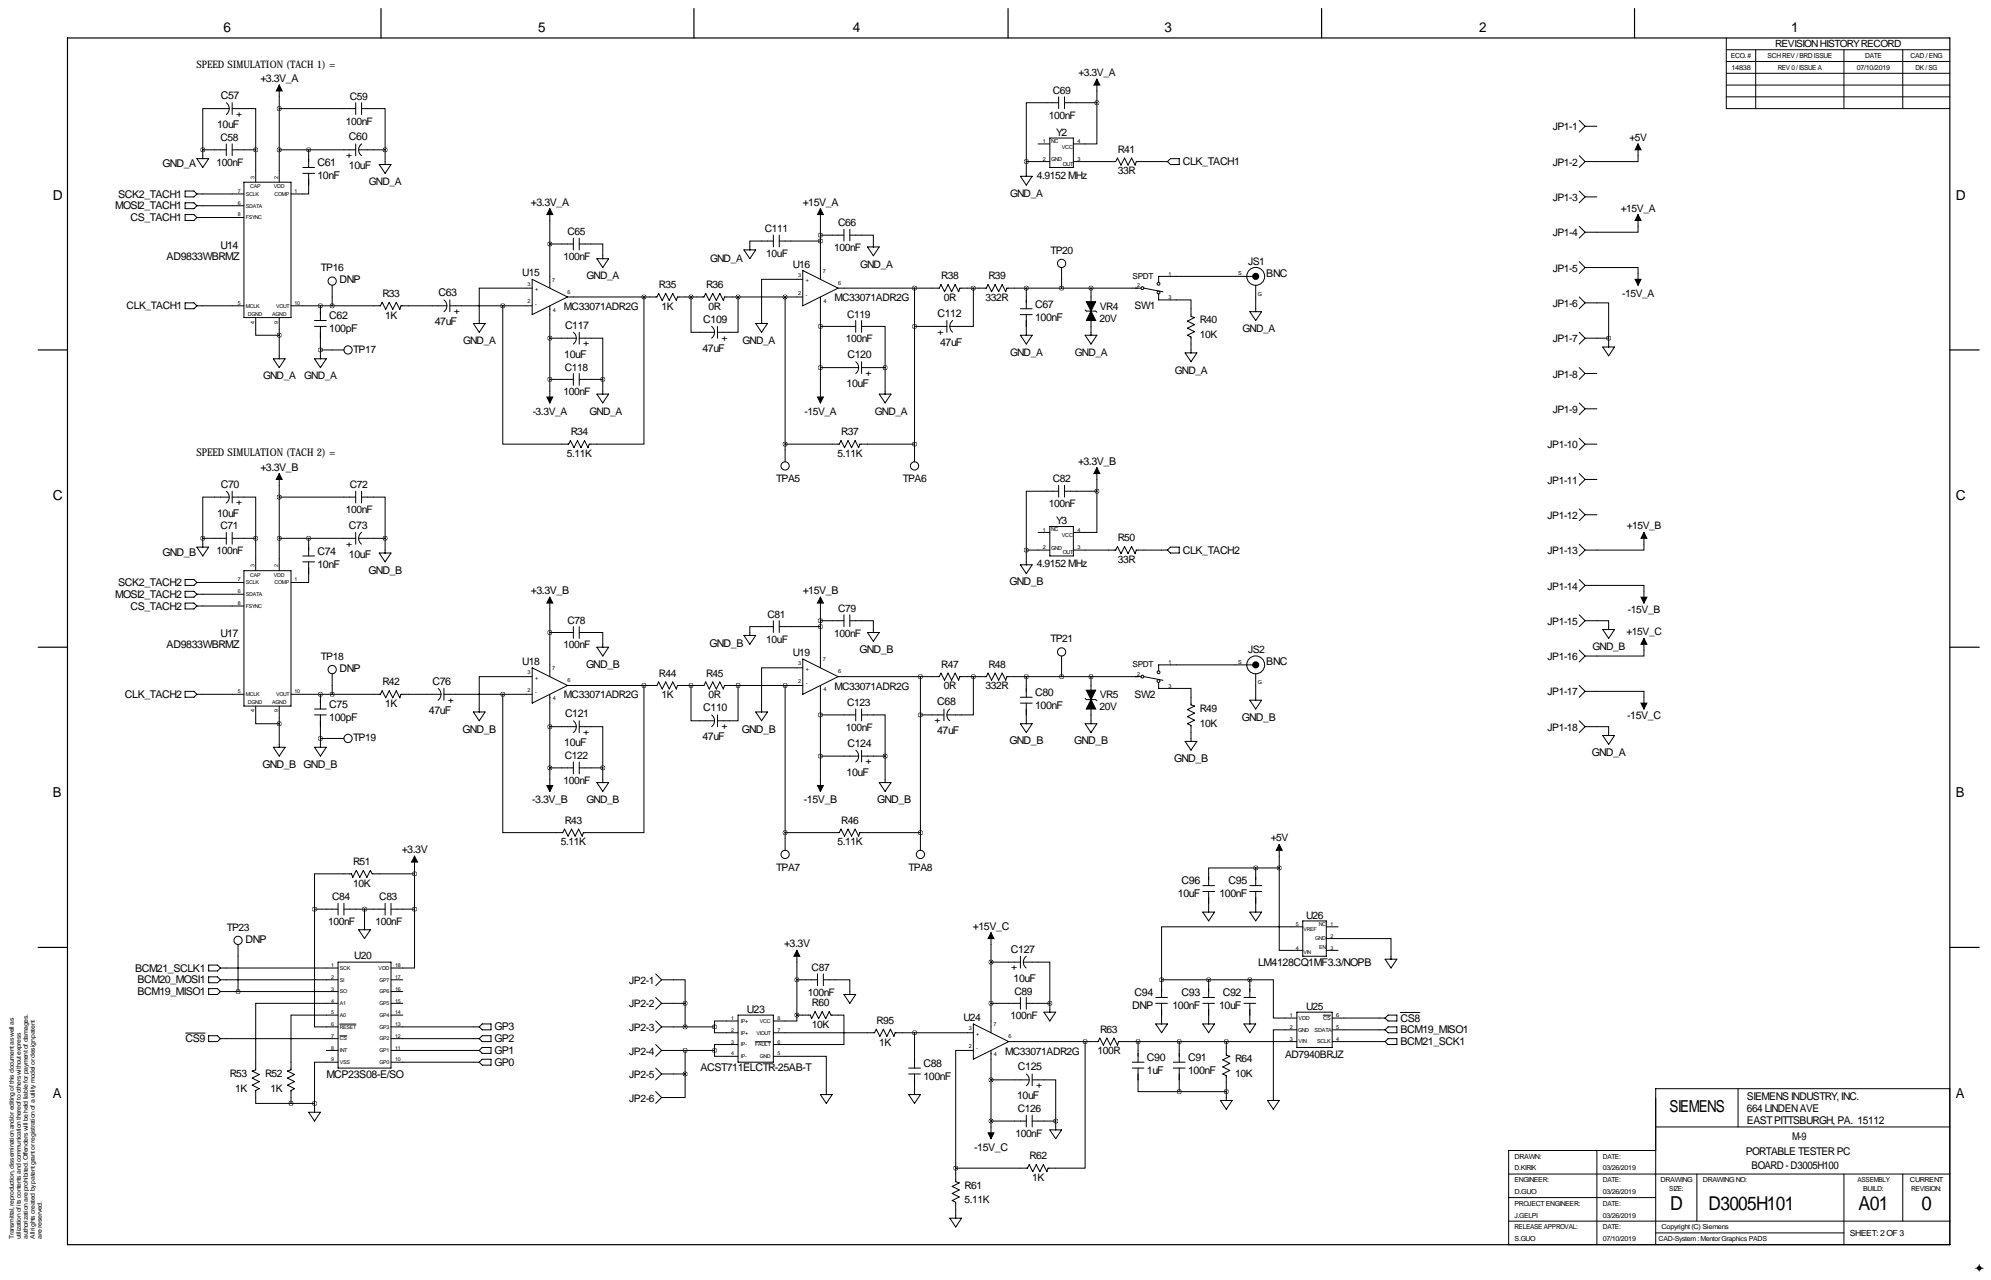
[picture p17: page 2]

authorization are prohibited. Offenders will be held liable for payment of damages.

Transmittal, reproduction, dissemination and/or editing of this document as well as

All rights created by patent grant or registration of a utility model or design patent

utilization of its contents and communication thereof to others without express

D

D

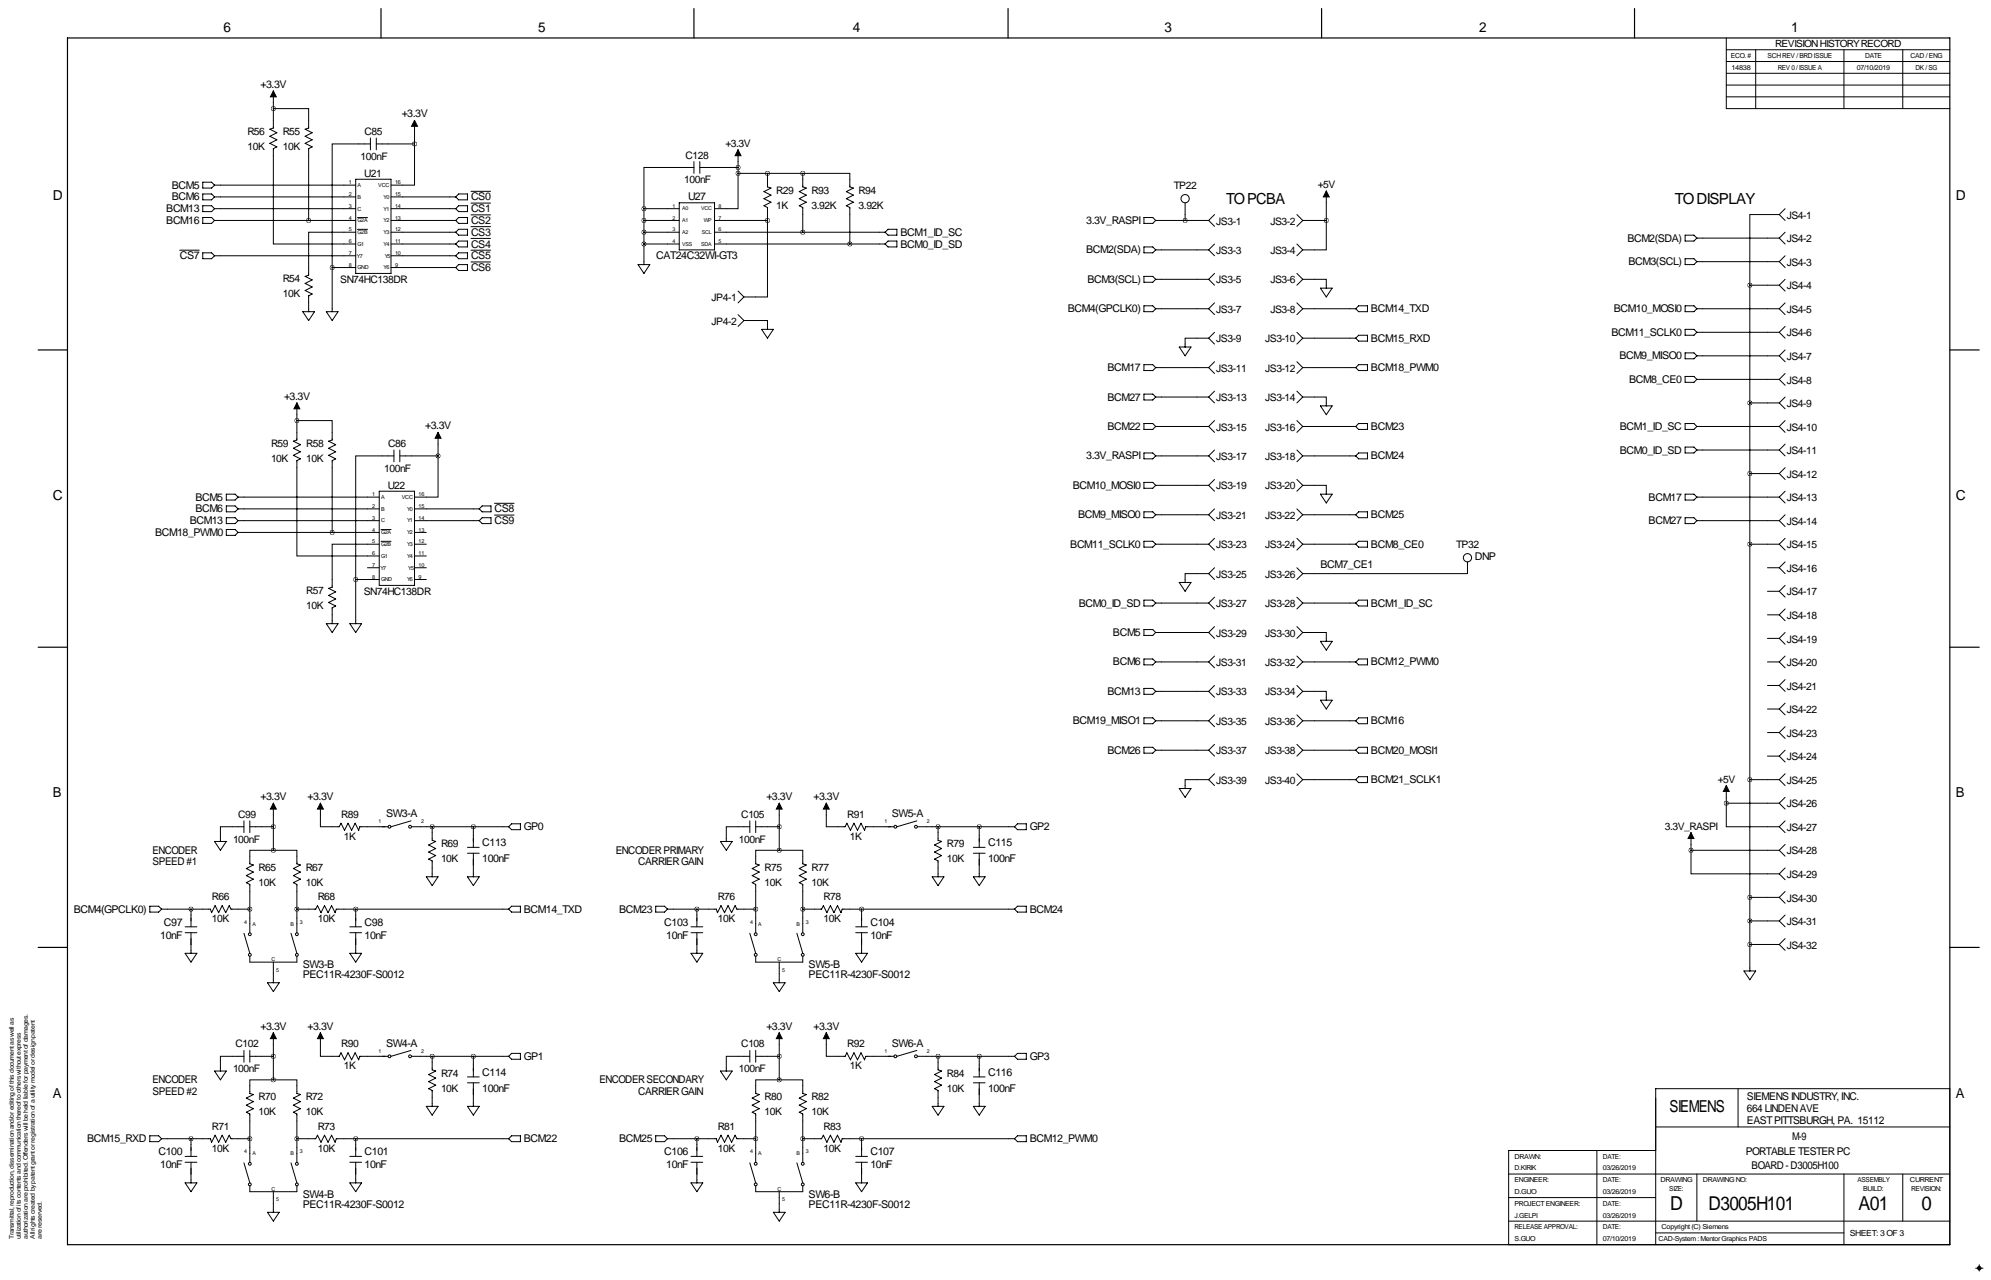
[picture p18: page 3]

authorization are prohibited. Offenders will be held liable for payment of damages.

Transmittal, reproduction, dissemination and/or editing of this document as well as

All rights created by patent grant or registration of a utility model or design patent

utilization of its contents and communication thereof to others without express
