wmarchewka/class_4_test/docs/D3005H100-A/BOT PASTEMASK.pdf

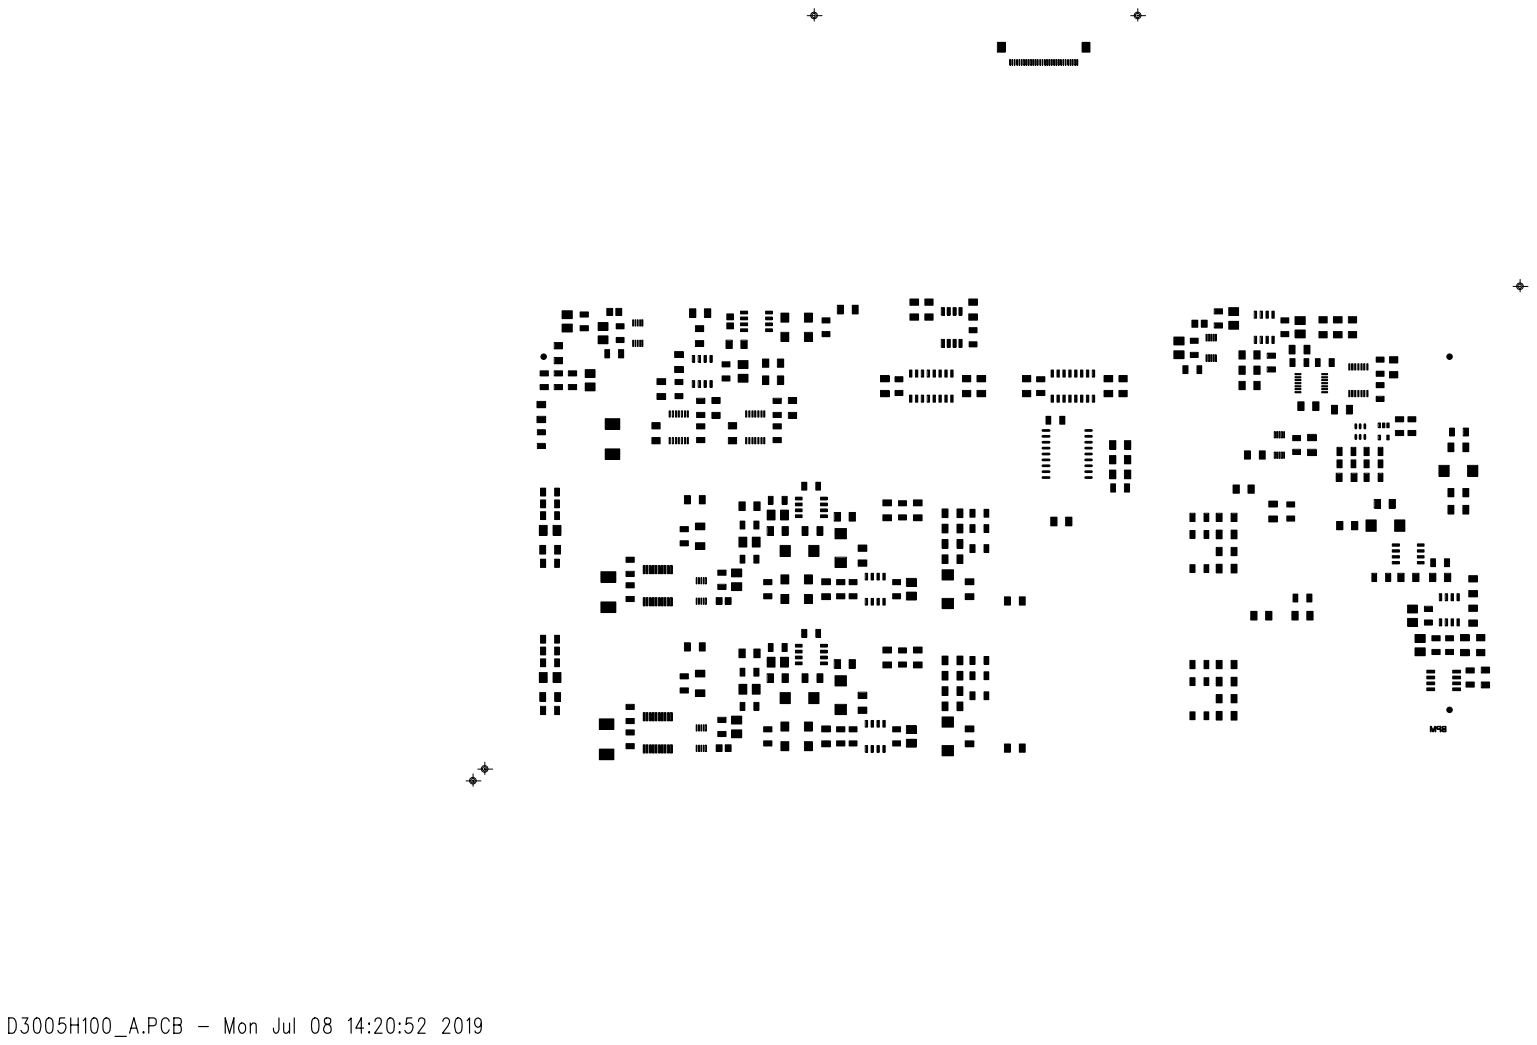
[picture p19: page 1]
