wmarchewka/class_4_test/docs/D3005H100-A/BOT SILKSCREEN.pdf

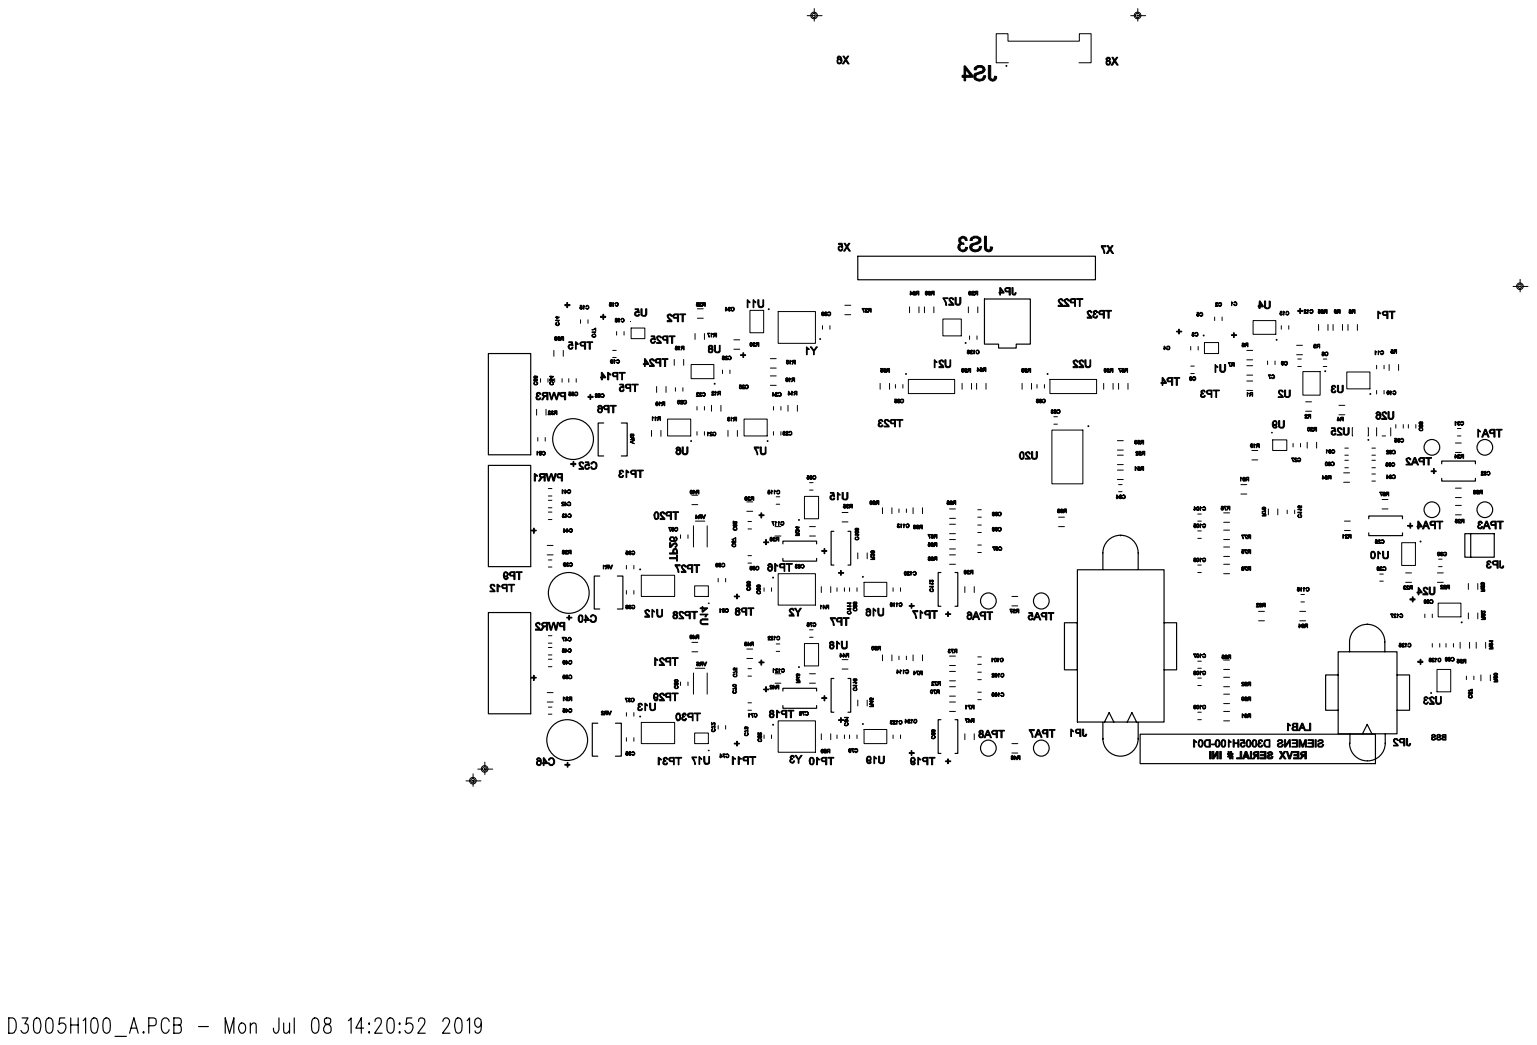
[picture p20: page 1]
