wmarchewka/class_4_test/docs/D3005H100-A/BOT.pdf

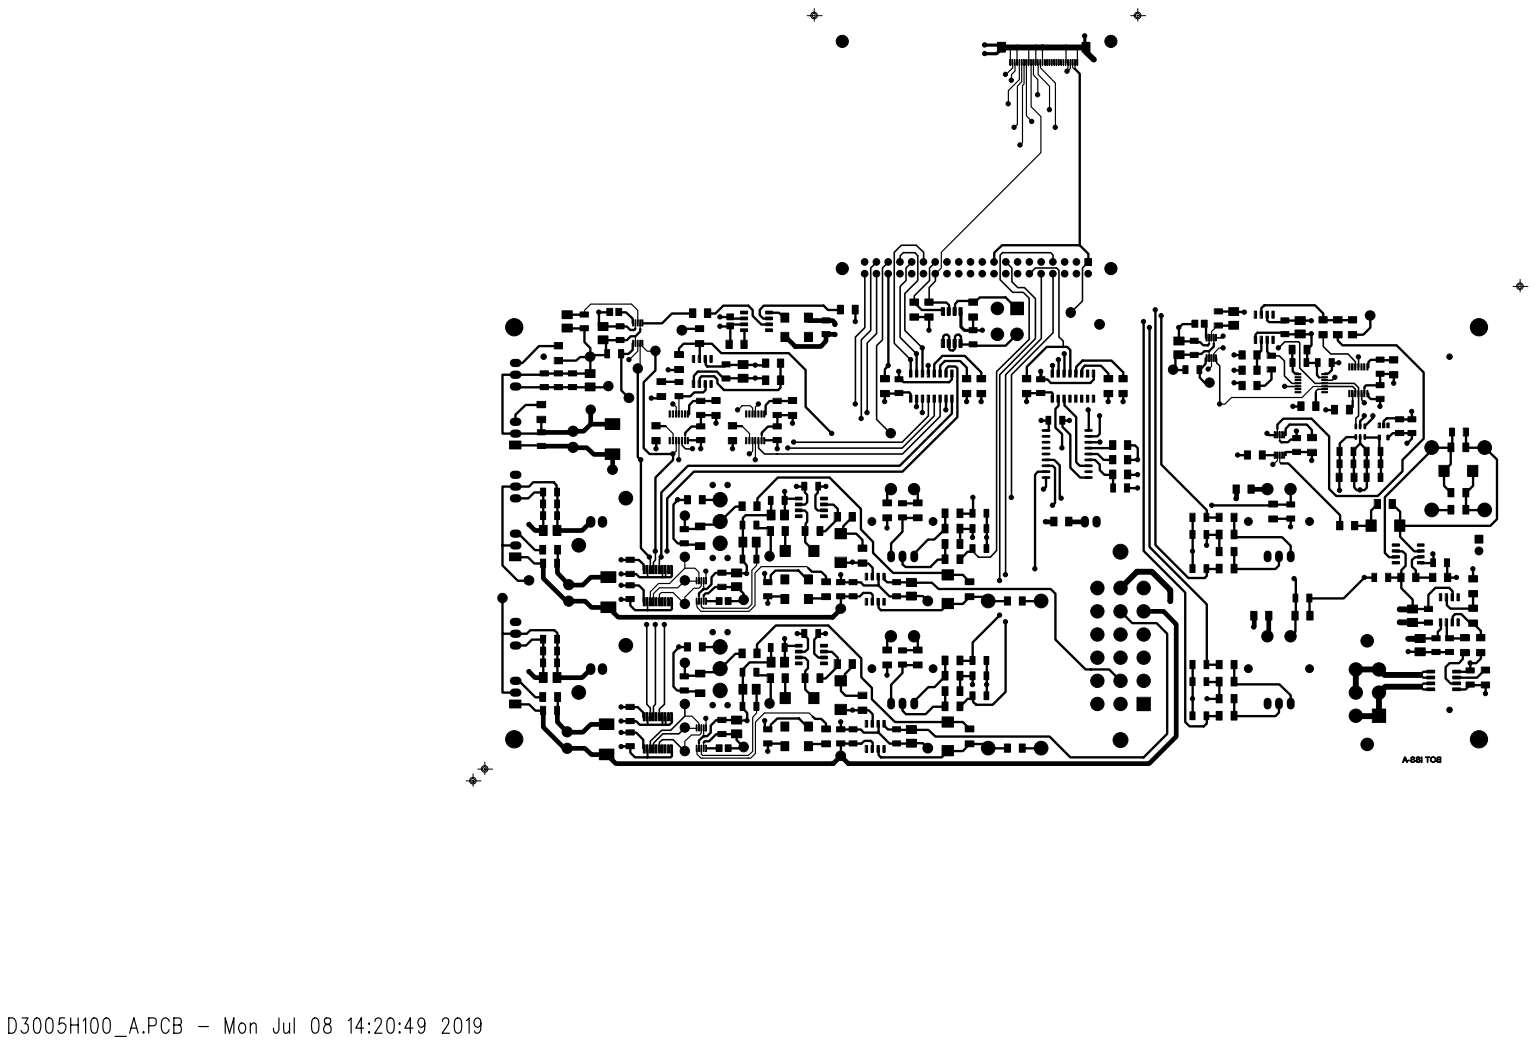
[picture p21: page 1]
