wmarchewka/class_4_test/docs/D3005H100-A/INN2.pdf

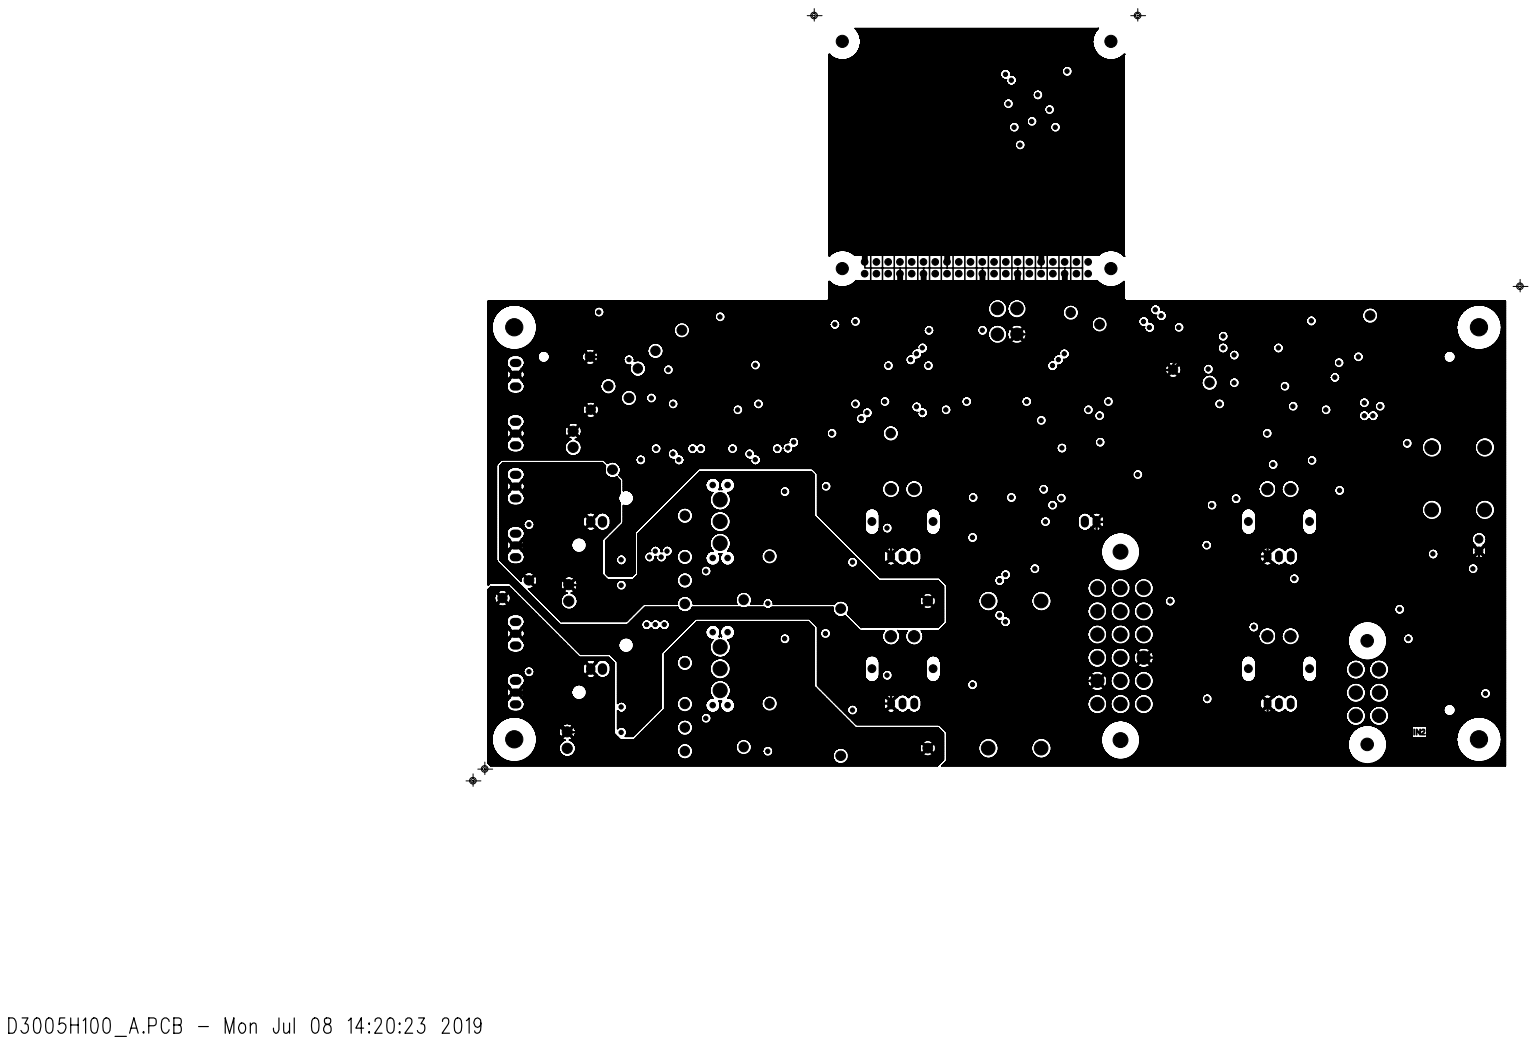
[picture p22: page 1]
