wmarchewka/class_4_test/docs/D3005H100-A/INN3.pdf

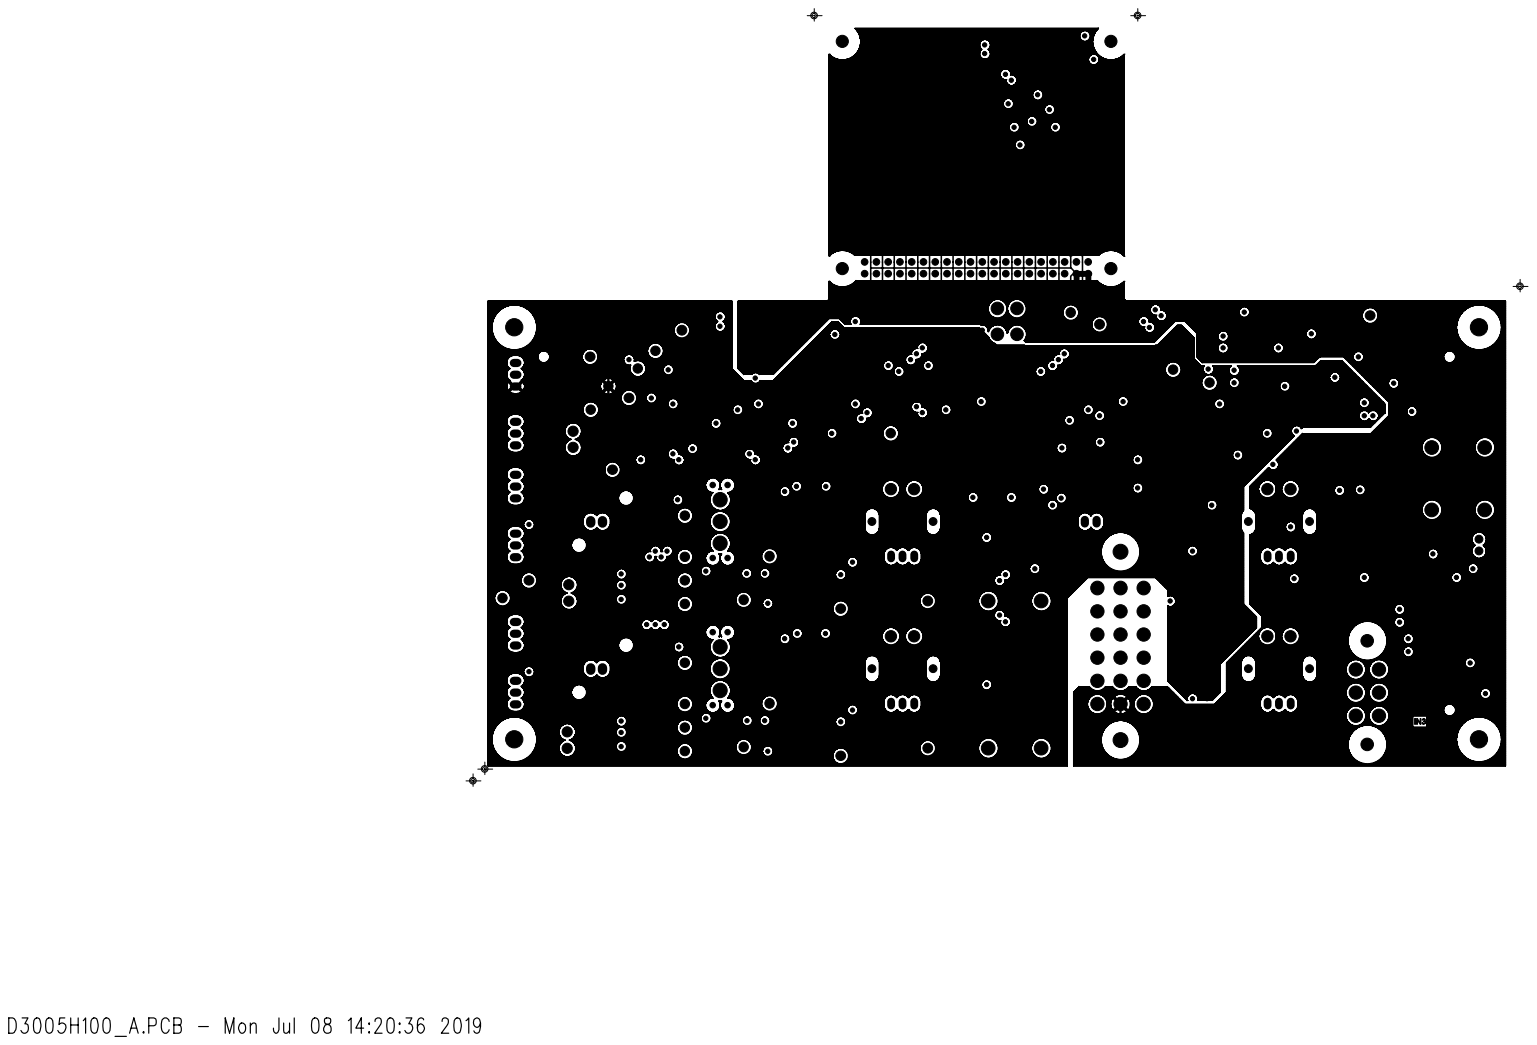
[picture p23: page 1]
