wmarchewka/class_4_test/docs/D3005H100-A/TOP SILKSCREEN.pdf

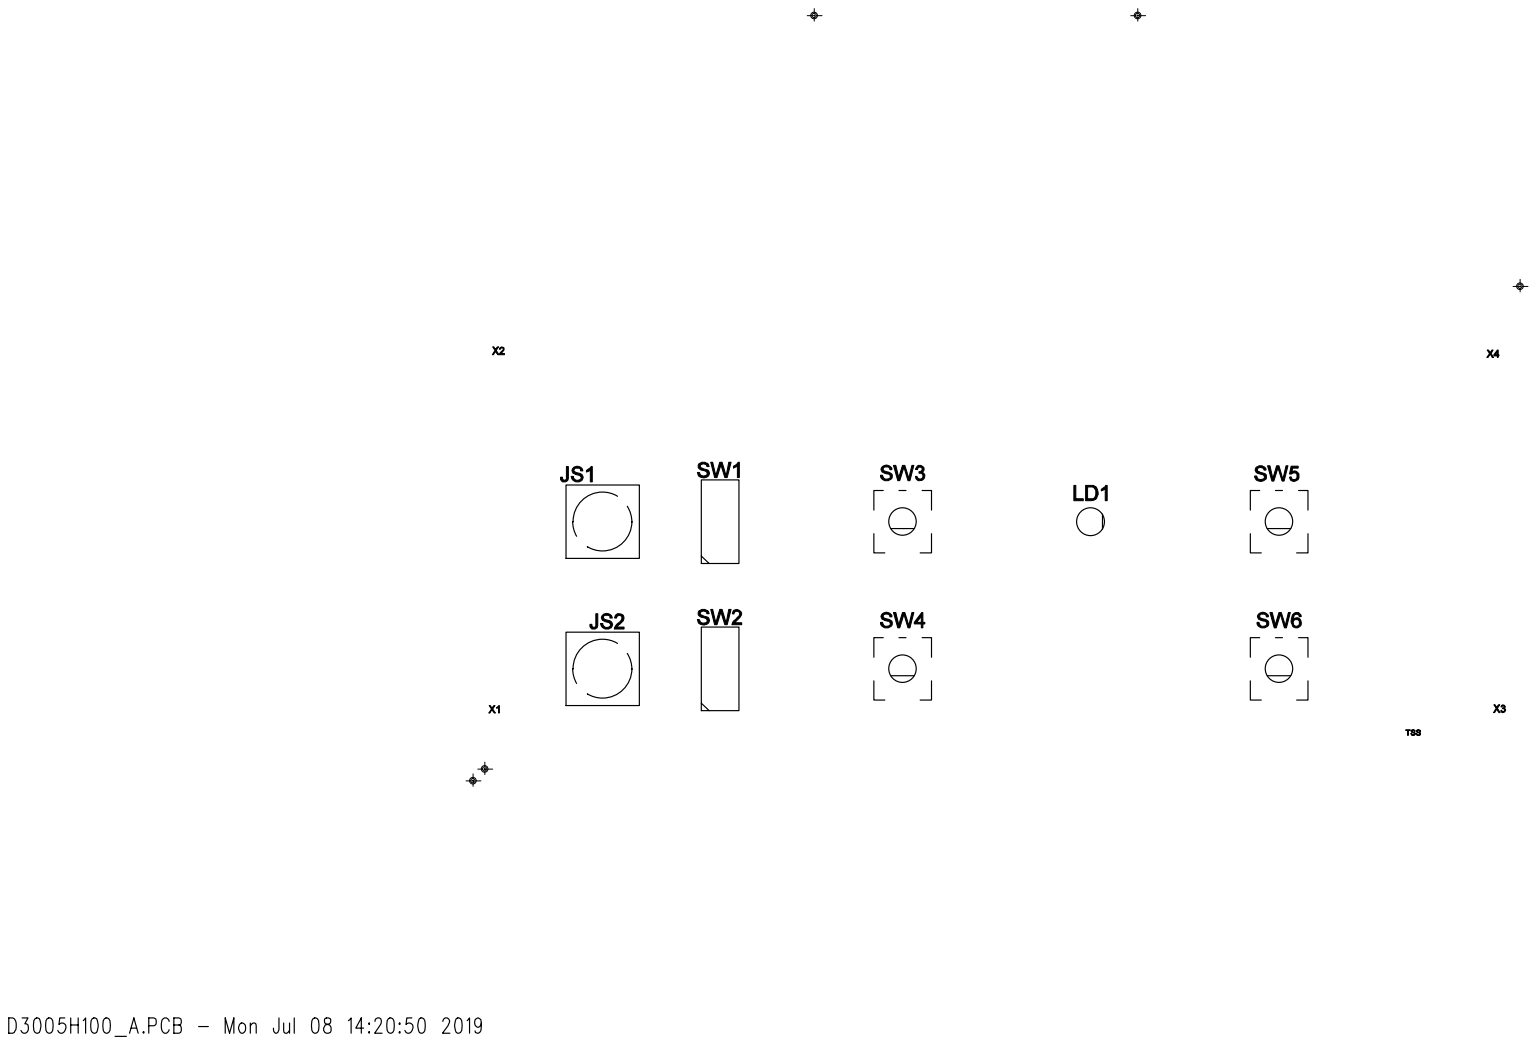
[picture p24: page 1]
