wmarchewka/class_4_test/docs/D3005H100-A/TOP.pdf

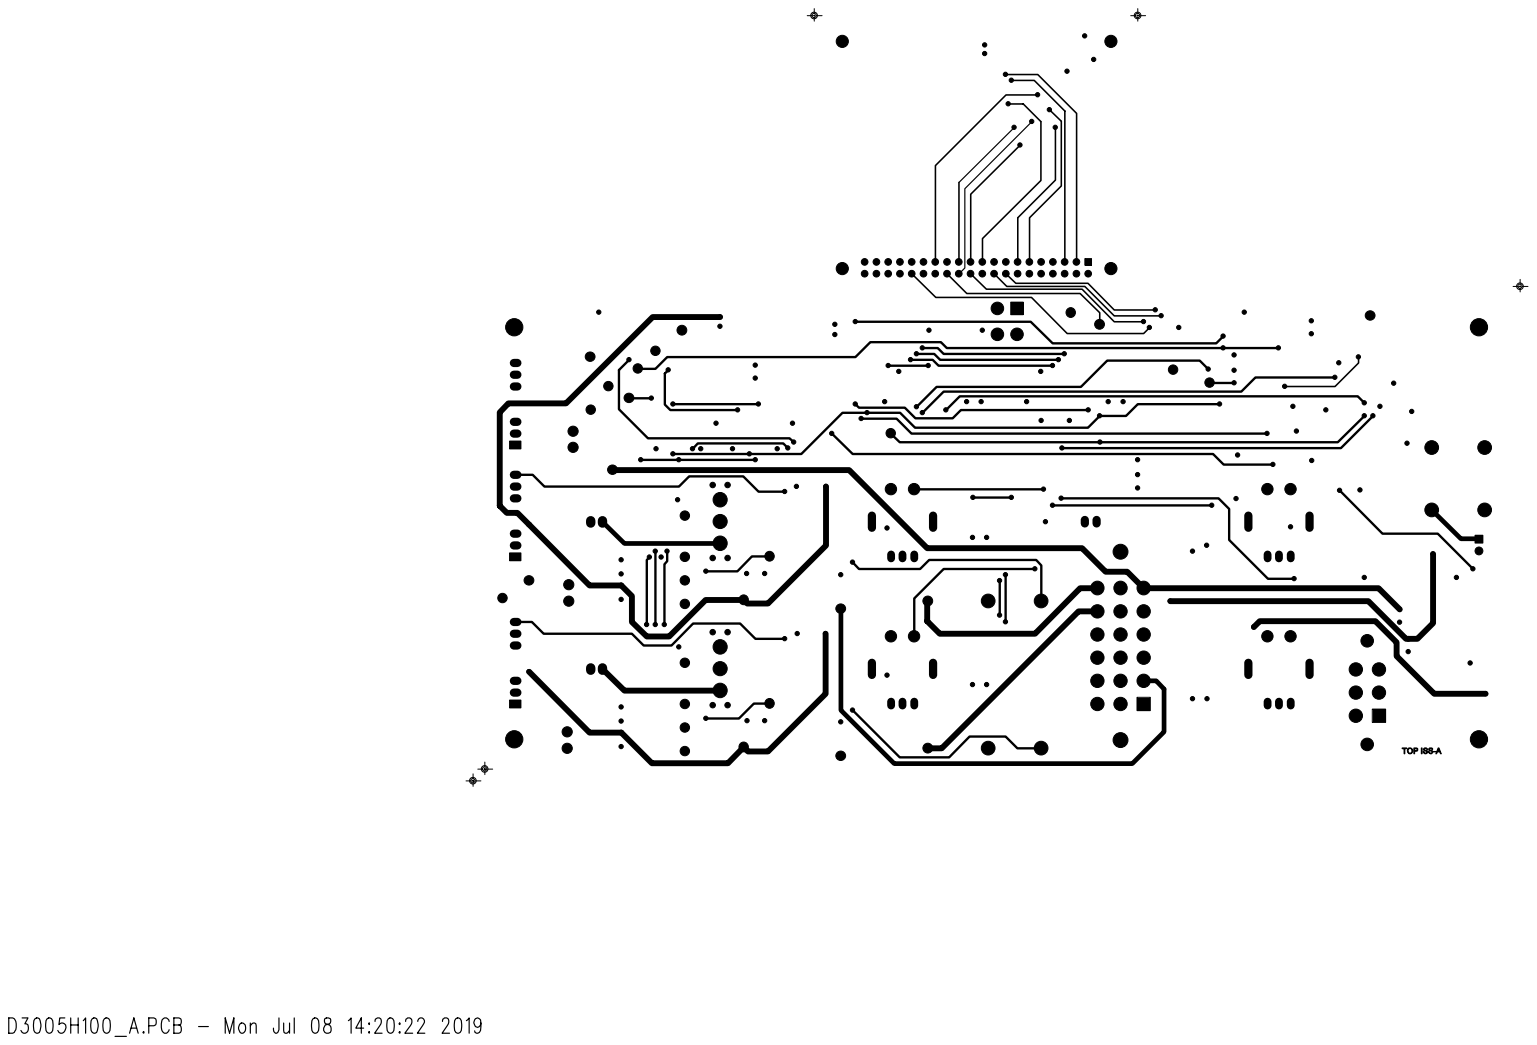
[picture p25: page 1]
