wmarchewka/class_4_test/(list of files, drawings)

Other design files:
docs/Compute Module/Board Design/RPI-CMIO-V3_0-PUBLIC.DSN
docs/D3005H100-A/D3005H100_A.pcb
docs/D3005H100_A.pcb
docs/D3005H102_A.pcb
