wmarchewka/class_4_test/config/config.ini

[MAIN]
guiname = gui/New_MAIN2.ui
display_brightness = 20
display_timer_interval = 100
sense_timer_interval = 100
switch_timer_interval = 50
poll_timer_interval = 50
communication_timer_interval = 1000
screen_brightness_max = 31
screen_brightness_min = 1

[GPIO]
ports = 2, 3, 4, 17, 27, 22, 10, 9, 11, 5, 6, 13, 19, 26, 14, 15, 18, 23, 24, 25, 8, 7, 12, 16, 20, 21

[ROTARY]


[DIGITAL_POT]
fine_wiper_increment = 1
fine_wiper_decrement = 1
coarse_wiper_increment = 5
coarse_wiper_decrement = 5


[SPEEDGEN]
freq_regs_min = 0
freq_regs_max = 547827
primary_source_frequency = 4915200
secondary_source_frequency = 4915200
primary_freq_gen_constant = 268435456
secondary_freq_gen_constant = 268435456
reg_off = 0x21, 0x20
speed_0_cs = 6
speed_1_cs = 7
set_speed_spi_header = 0x20, 0x00
code_rate_mux_pin = 26
speed_0_thresholds = [0,500],[20,200],[50,50],[200,5],[500,2],[1000,1]  #[ms,increment]
speed_1_thresholds = [0,500],[20,200],[50,50],[200,5],[500,2],[1000,1]
rotary_0_pins = 4, 14
rotary_1_pins = 15, 22
rotary_0_pin_0_debounce_microseconds = 1000
rotary_0_pin_1_debounce_microseconds = 1000
rotary_1_pin_0_debounce_microseconds = 1000
rotary_1_pin_1_debounce_microseconds = 1000
speed_0_shape = 0
speed_1_shape = 0
speed_0_name = SPEED0
speed_1_name = SPEED1
speed_0_spi_channel = 2
speed_1_spi_channel = 2
fine_wiper_min_bits = 0
fine_wiper_max_bits = 1024
coarse_wiper_min_bits = 0
coarse_wiper_max_bits = 1024
SPEED_FREQUENCY_MIN = 0
SPEED_FREQUENCY_MAX = 1000000
FREQ_SHAPE_SINE = 0
FREQ_SHAPE_SQUARE = 1
FREQ_SHAPE_TRIANGLE = 2
CLOCKWISE = 1
ANTI_CLOCKWISE = -1
DIRECTION_ERROR = 0
ERROR = 0
SPEED_REG = 0
FREQ_SHAPE = ['SINE', 'SQUARE', 'TRIANGLE']

[DECODER]
pin_select = [0, 0, 0],[1, 0, 0],[0, 1, 0],[1, 1, 0],[0, 0, 1],[1, 0, 1],[0, 1, 1],[1, 1, 1],[0, 0, 0],[1, 0, 0]
decoder_pin_a = 5
decoder_pin_b = 6
decoder_pin_c = 13

[DISPLAY]
touchscreen = rpi
brightness = 10

[SPI]
devices = spidev1.0,spidev1.1,spidev1.2,spidev0.0,spidev0.1
spi_bus = 1
spi1_0_chip_select = 0
spi1_2_chip_select = 2
spi1_0_max_speed_hz = 976000
spi1_2_max_speed_hz = 976000
spi1_0_mode = 0
spi1_2_mode = 2

[CURRENTSENSE]
adc_scale = 10.83
sense_amp_max_amps = 25
sense_ad_vin = 3.299
sense_ad_max_bits = 14
sense_scaling_factor_mv_amp = 0.110
display_amps_template = {:2.3f}
loop_current_template = {:3.1f}
adc_counts_template = {:2.3f}
adc_template = {:2.3f}

[EEPROM]
company = SIEMENS MOBILITY
software_version = 1.0.0
board_version = 1.0.0

[CODEGEN]
coded_carrier_pin = 26
primary_channel_chip_select_pin = 0
secondary_channel_chip_select_pin = 2
primary_source_frequency = 4915200
secondary_source_frequency = 4915200
shape_sine = 0
shape_square = 1
shape_triangle = 2
duty_cycle = 50.0
pulses_per_second = 1000000.0
primary_channel_mux_pin = 0
secondary_channel_mux_pin = 1
shape_sine_word = 0x02000
shape_square_word = 0x2020
shape_triangle_word = 0x2002


[GAINS]
gain_0_cs = 0
gain_1_cs = 2
rotary_2_pins = 23, 24
rotary_3_pins = 25, 12
rotary_2_pin_0_debounce_microseconds = 1000
rotary_2_pin_1_debounce_microseconds = 1000
rotary_3_pin_0_debounce_microseconds = 1000
rotary_3_pin_1_debounce_microseconds = 1000
gain_0_thresholds = [10,2000],[20,500],[50,200],[200,100],[500,50],[1000,10]  #[ms,increment]
gain_1_thresholds = [10,2000],[20,500],[50,200],[200,100],[500,50],[1000,10]  #[ms,increment]
gain_0_name = GAIN0
gain_1_name = GAIN1
gain_0_spi_channel = 2
gain_1_spi_channel = 2

[SWITCH]
switch_chip_select = 9
