wmarchewka/class_4_test/support/support.py

import os
import platform as pf
import sys
import subprocess
import PySide2
from PySide2 import QtCore

#my libraries
from config import Config
from logger import Logger

class Support():
    ostype = ""

    Logger.log.info("Instantiating {} class...".format(__qualname__))


    def __init__(self, config, logger):
        self.log.debug("{} init complete...".format(__name__))
        self.config = config
        self.logger = logger
        self.log = Logger.log
        self.log.info('Starting up portable tester...')
        self.startup_processes()
        self.log.debug("{} init complete...".format(__name__))

    # *****************************************************************************************
    def startup_processes(self):
        self.config_file_path = "config/config.ini"
        self.ostype = None
        self.operating_system_detect()
        self.qt_version_query()
        self.pyqt_version_query()
        self.rpi_touchscreen_status()
        self.spi_device_query()
        self.rpi_version_query()

    # **************************************************************************
    def operating_system_detect(self):
        self.log.info("Getting OS TYPE...")
        os_type = None
        platform = pf.system()
        if platform == 'Windows':
            os_type = 'Windows'
        elif platform == 'Linux':
            os_type = 'rpi'
        elif platform == "Darwin":
            os_type = 'MAC'
        self.log.info("OS type found  = {}".format(os_type))
        if os_type != 'rpi':
            self.log.debug('Using fake-rpi as gpio')
            import fake_rpi
            sys.modules['RPi'] = fake_rpi.RPi  # Fake RPi (gpio)
            sys.modules['smbus'] = fake_rpi.smbus  # Fake smbus (I2C)
            sys.modules['RPi.gpio'] = fake_rpi.RPi.GPIO
        else:
            self.log.info('Using pigpio as gpio')
        self.ostype = os_type

    #*****************************************************************************************
    def brightness_get(self):
        screen_brightness = self.brightness_query()
        return screen_brightness

    # *****************************************************************************************
    def qt_version_query(self):
        self.log.info("Qt version: {}".format(PySide2.QtCore.__version__))

    # *****************************************************************************************
    def pyqt_version_query(self):
        self.log.info("PyQt version: {}".format(PySide2.__version__))

    # *****************************************************************************************
    def gen4_touchscreen_status(self):
        if self.ostype == 'rpi':
            self.log.info('Checking for Gen4 Touchscreen...')

    # *****************************************************************************************
    def rpi_touchscreen_status(self):
        if self.ostype == 'rpi':
            my_cmd = os.popen('sudo dmesg | grep -i ft5406').read()
            result = my_cmd.find('FT5406 memory based driver as /devices/virtual/input')
            if result:
                self.log.info('Found TOUCHSCREEN')
                self.config.configuration_save('DISPLAY', 'touchscreen', self.ostype)

    # *****************************************************************************************
    def rpi_version_query(self):
        try:
            if self.ostype == 'rpi':
                my_cmd = os.popen('sudo gpio -v').read()
                result = my_cmd.splitlines()
                self.log.info("Raspberry Pi Model:{}".format(result[8]))
        except:
            self.log.exception("EXCEPTION in rpi_version_query", exc_info=True)

    # *****************************************************************************************
    def spi_device_query(self):
        if self.ostype == 'rpi':
            try:
                list_of_files = os.listdir('/dev')
                spidevices = self.config.config.get('SPI', 'devices')
                spidevices = spidevices.split(',')
                for list in spidevices:
                    if list in list_of_files:
                        self.log.info('Found SPI device: {}'.format(list))
                    else:
                        self.log.info('Missing SPI device: {}'.format(list))
                        if list == 'spidev1.0' or list == 'spidev1.2':
                            self.log.error('ERROR:  Missing SPI Driver !!!')
            except Exception:
                self.log.error('SPI ERROR')

    # *****************************************************************************************
    def brightness_set(self, value):
        try:
            if self.ostype == 'rpi':
                # sudo sh -c "echo 31 > /sys/class/backlight/4d-hats/brightness"
                os.popen("sudo sh -c 'echo " + str(value) + "  > /sys/class/backlight/4d-hats/brightness'")
                brightness = self.brightness_query()
                if brightness == "":
                    return None
                else:
                    return
        except Exception as inst:
            self.log.critical(inst)

    # *****************************************************************************************
    def brightness_query(self):
        try:
            if self.ostype == 'rpi':
                my_cmd = os.popen('sudo cat /sys/class/backlight/4d-hats/actual_brightness', 'r').read()
                my_cmd = my_cmd.rstrip()
                self.log.info('Brightness level returned as {}'.format(my_cmd))
                return my_cmd
            else:
                my_cmd = 15
                return my_cmd
        except Exception as inst:
            self.log.critical(inst)

    #*****************************************************************************************
    # called premade script to create ramdrive
    # TODO see why ramdrive is getting created upon reboot.
    def ram_drive_create(self):
        self.log.debug("Creating RAMDRIVE")
        cwd = os.getcwd()
        path = cwd + "/scripts/ram_drive_create.sh"
        if os.path.exists("/var/ramdrive"):
            self.log.debug("RAM DRIVE exists...")
        else:
            try:
                ret = subprocess.Popen(['sh', path])
            except:
                pass
