wmarchewka/class_4_test/text_logger.py

from PySide2 import QtWidgets
import logging


class QTextEditLogger(logging.Handler):
    def __init__(self, parent):
        super().__init__()
        self.widget = QtWidgets.QPlainTextEdit(parent)
        self.widget.setReadOnly(True)

    def emit(self, record):
        msg = self.format(record)
        self.widget.appendPlainText(msg)

    def write(self, m):
        pass
